baalsmn/kbd-workshop/hachigo74/renders/hachigo74_case_centre.png

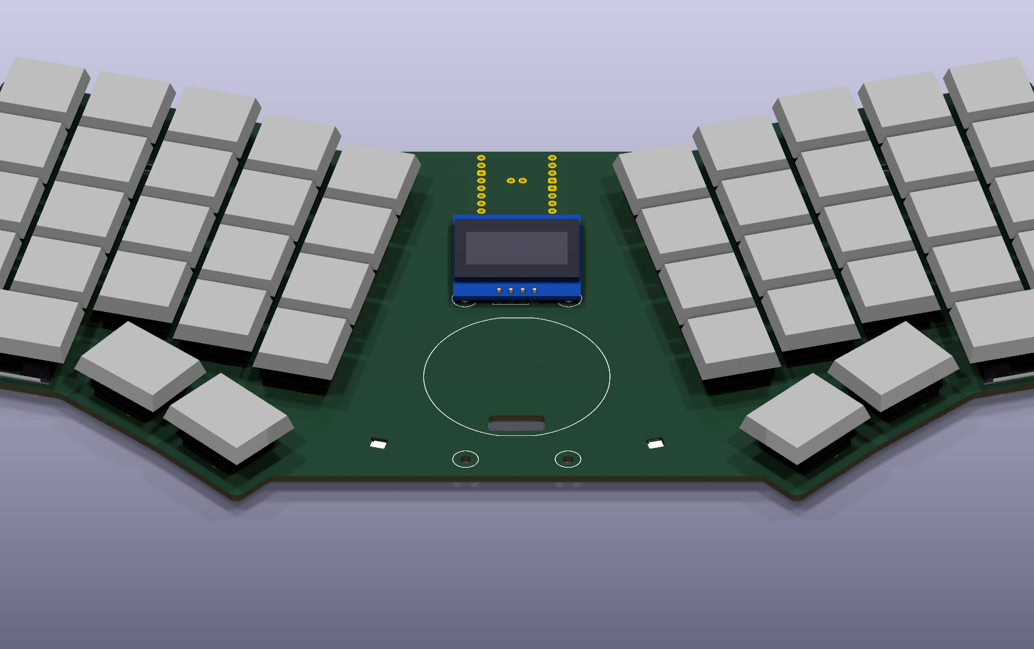
hachigo74/renders/hachigo74_case_centre.png
