baalsmn/kbd-workshop/hachigo74/renders/hachigo74_case_iso.png

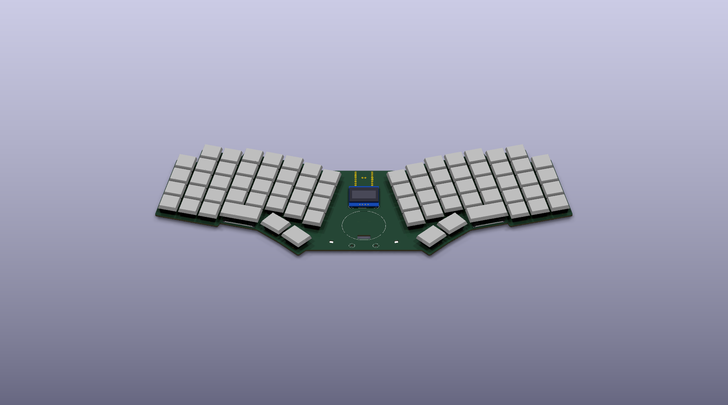
hachigo74/renders/hachigo74_case_iso.png
