baalsmn/kbd-workshop/hachigo74/renders/hachigo74_case_top.png

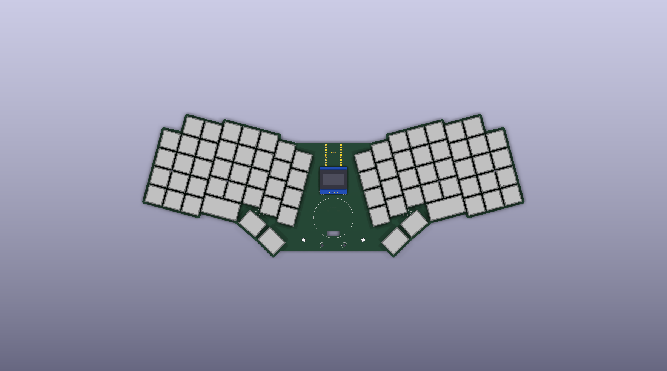
hachigo74/renders/hachigo74_case_top.png
