baalsmn/kbd-workshop/kugo82/kugo82_back.png

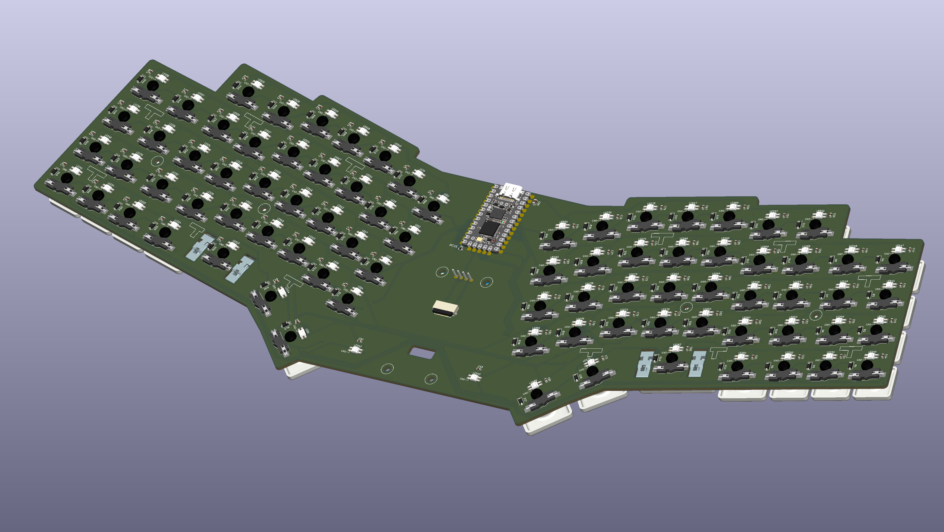
kugo82/kugo82_back.png
