baalsmn/kbd-workshop/kugo82/kugo82_front.png

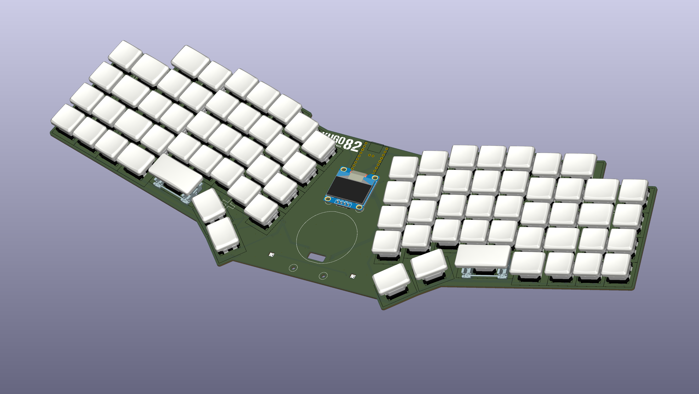
kugo82/kugo82_front.png
