baalsmn/kbd-workshop/hachigo74/case/step/wedge_6deg_assembly.step

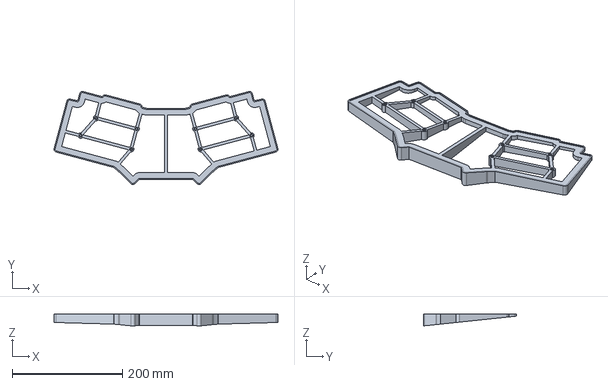
[picture p8: CAD file, 2026-11-07]
hachigo74/case/step/wedge_6deg_assembly.step
406.5 x 168.9 x 21.5 mm
