baalsmn/kbd-workshop/hachigo74/case/fusion/center_cover_threaded.stl

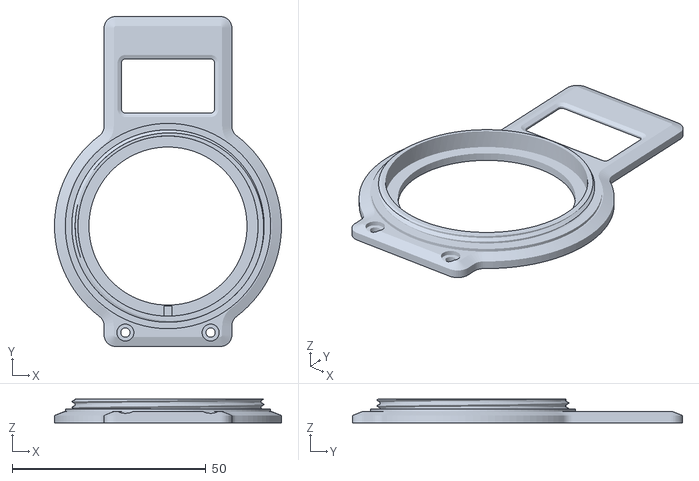
[picture p9: CAD file, 2026-11-07]
hachigo74/case/fusion/center_cover_threaded.stl
58.6 x 85.2 x 6.10
