baalsmn/kbd-workshop/hachigo74/case/step/oled_spacers.step

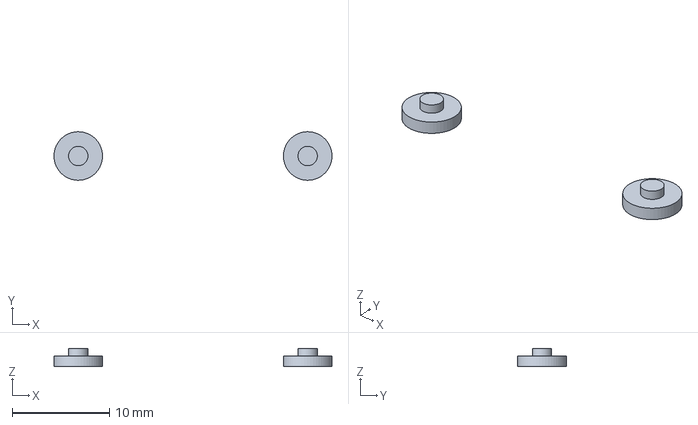
[picture p10: CAD file, 2026-11-07]
hachigo74/case/step/oled_spacers.step
28.6 x 5.00 x 1.90 mm
