baalsmn/kbd-workshop/hachigo74/case/test/switch_cutout_14.06_strip.step

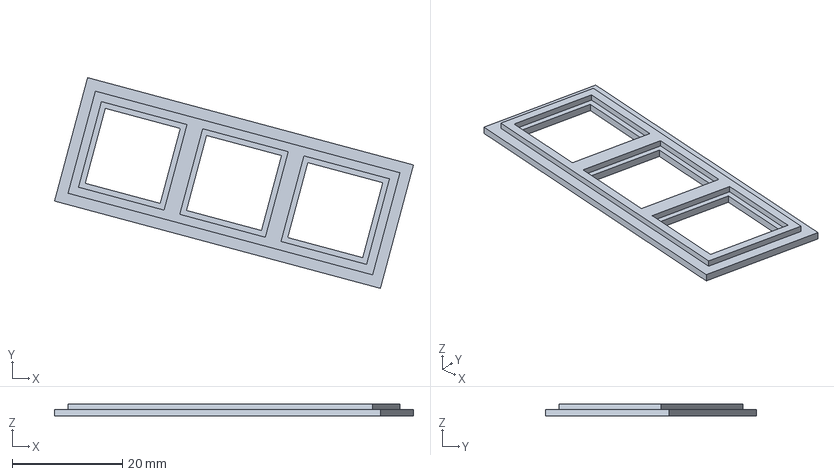
[picture p11: CAD file, 2026-11-04]
hachigo74/case/test/switch_cutout_14.06_strip.step
65.1 x 38.2 x 2.20 mm
