baalsmn/kbd-workshop/keycaps/build/keycap-10-13.step

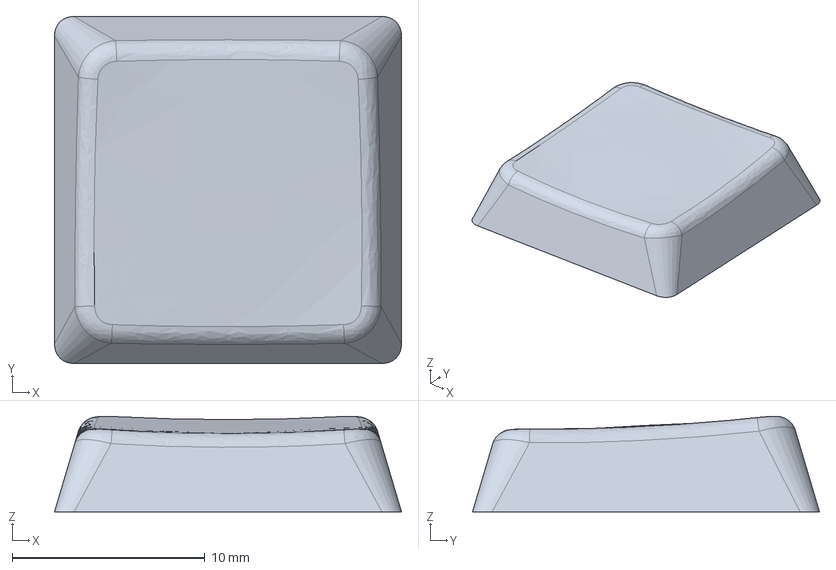
[picture p12: CAD file, 2026-10-24]
keycaps/build/keycap-10-13.step
18.0 x 18.0 x 4.95 mm
