baalsmn/kbd-workshop/keycaps/results/blank/cap_1u_blank.3mf

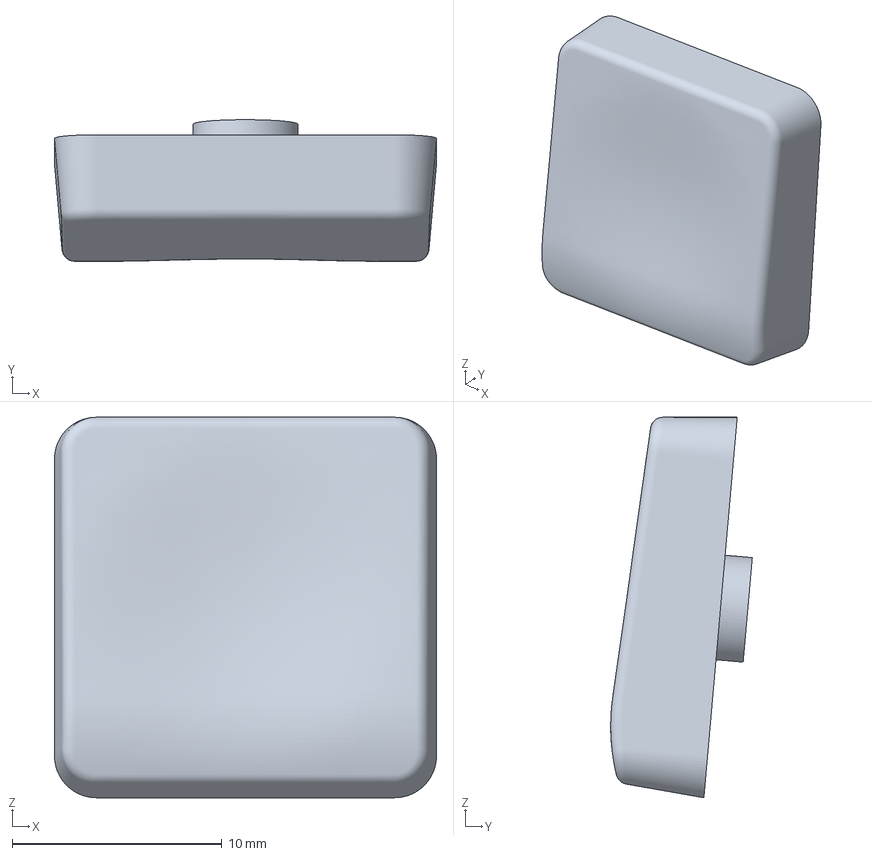
[picture p13: CAD file, 2026-11-10]
keycaps/results/blank/cap_1u_blank.3mf
18.2 x 6.75 x 18.1 mm
