baalsmn/kbd-workshop/keycaps/results/multicolor-legend/cap_1u_A.3mf

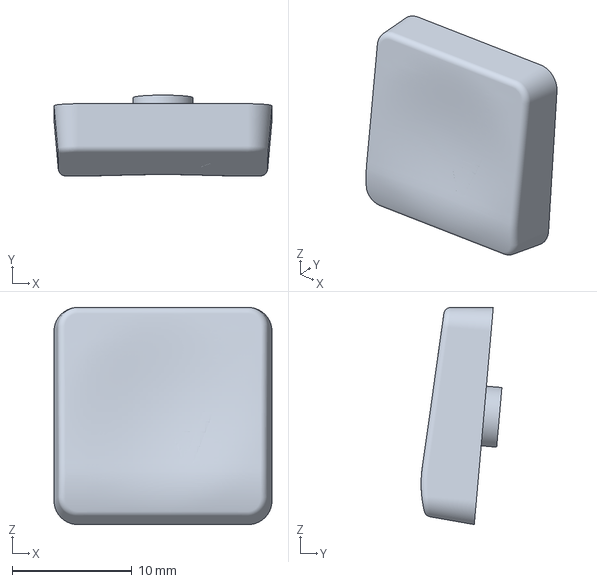
[picture p14: CAD file, 2026-11-10]
keycaps/results/multicolor-legend/cap_1u_A.3mf
18.2 x 6.75 x 18.1 mm
