baalsmn/kbd-workshop/kugo82/case/fusion/trackpad_ring_threaded.stl

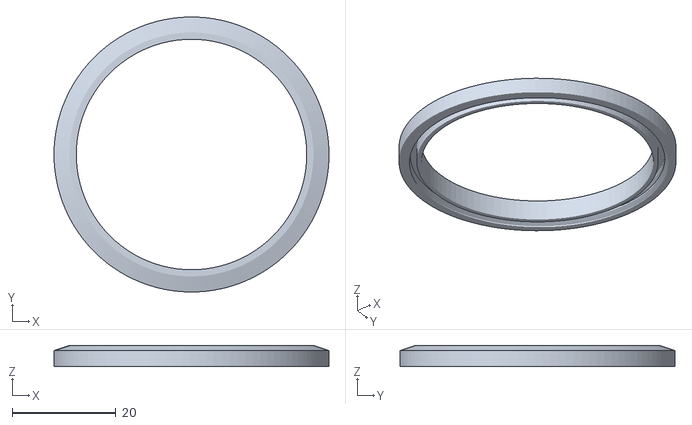
[picture p16: CAD file, 2026-11-07]
kugo82/case/fusion/trackpad_ring_threaded.stl
53.0 x 53.0 x 4.10
