baalsmn/kbd-workshop/kugo82/case/step/tub_left.step

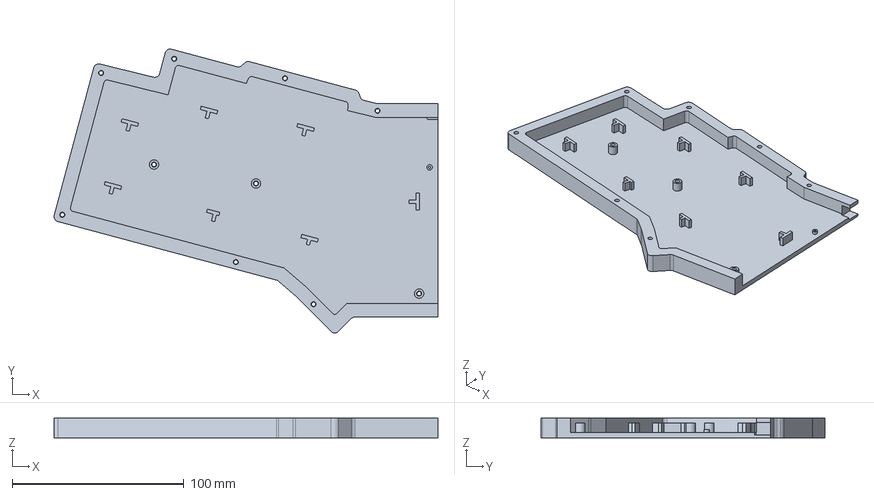
[picture p17: CAD file, 2026-11-07]
kugo82/case/step/tub_left.step
223.9 x 165.5 x 11.4 mm
