baalsmn/kbd-workshop/hachigo74/case/test/dovetail_strip_right.step

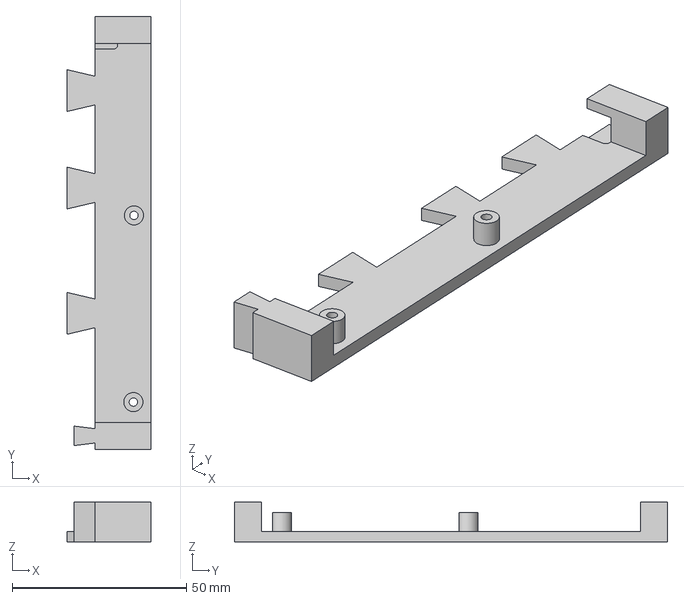
[picture p18: CAD file, 2026-11-04]
hachigo74/case/test/dovetail_strip_right.step
24.0 x 124.4 x 11.4 mm
