baalsmn/kbd-workshop/keycaps/results/blank/cap_1u_slope_0.3mf

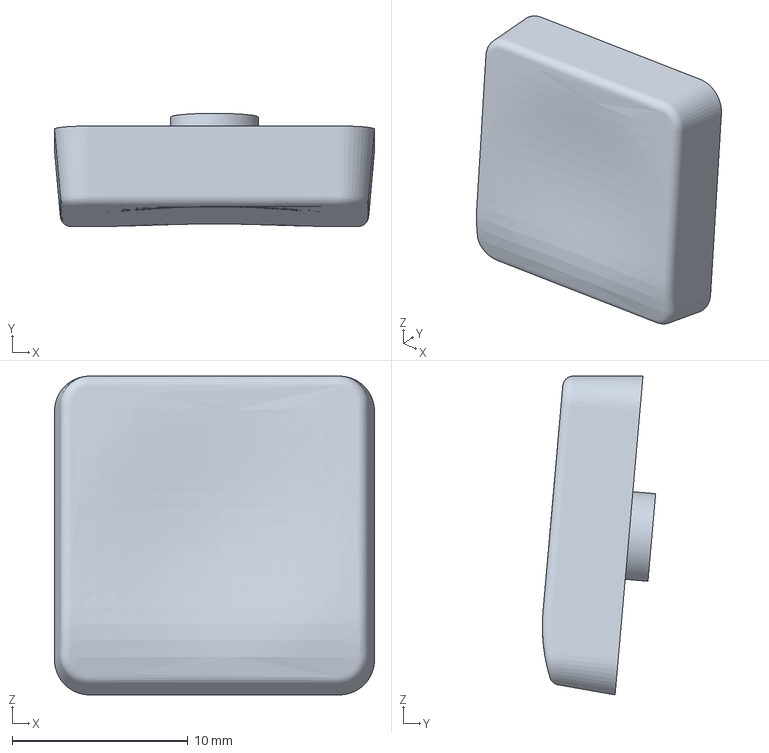
[picture p19: CAD file, 2026-11-10]
keycaps/results/blank/cap_1u_slope_0.3mf
18.2 x 6.44 x 18.1 mm
