baalsmn/kbd-workshop/keycaps/results/multicolor-legend/cap_1.5u_stem+0.5_A.3mf

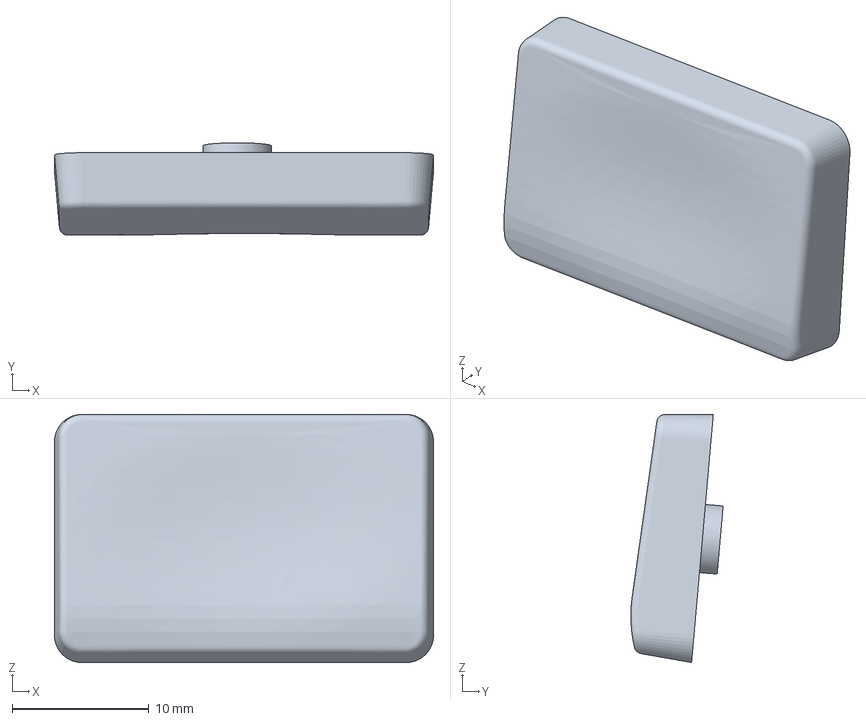
[picture p20: CAD file, 2026-11-10]
keycaps/results/multicolor-legend/cap_1.5u_stem+0.5_A.3mf
27.7 x 6.75 x 18.1 mm
