baalsmn/kbd-workshop/kicad-libraries/3dmodels/vendor_Gateron_KS-57B210T_stabilizer.step

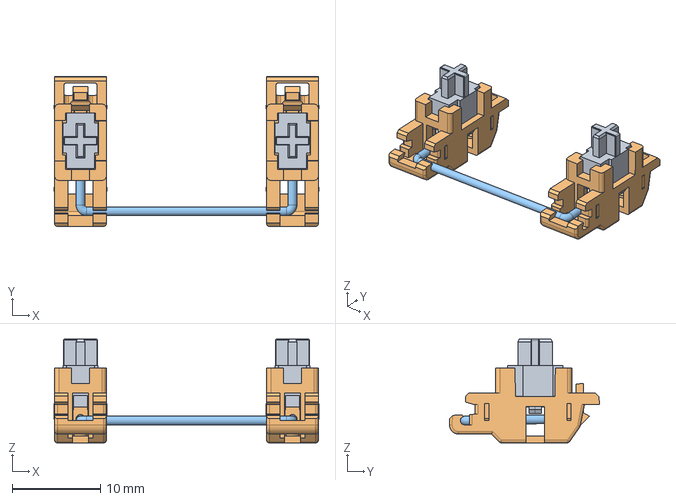
[picture p21: CAD file, 2026-10-22]
kicad-libraries/3dmodels/vendor_Gateron_KS-57B210T_stabilizer.step
30.0 x 17.0 x 11.8 mm
