baalsmn/kbd-workshop/kugo82/case/fusion/cover_clip_chamfered.stl

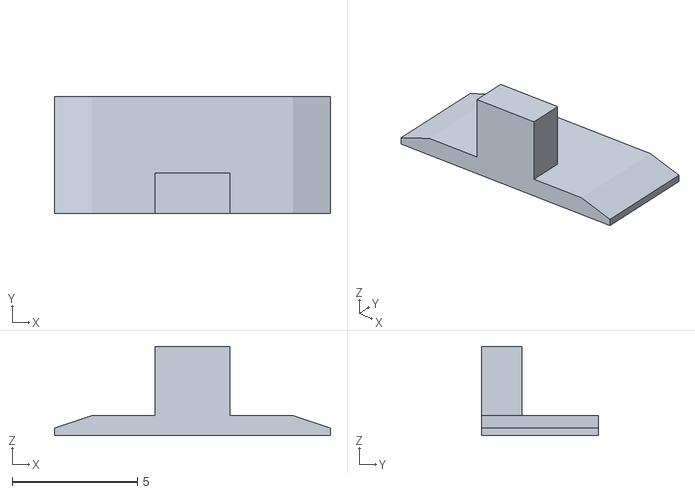
[picture p22: CAD file, 2026-11-07]
kugo82/case/fusion/cover_clip_chamfered.stl
11.0 x 4.65 x 3.55
