baalsmn/kbd-workshop/kugo82/case/step/trackpad_ring.step

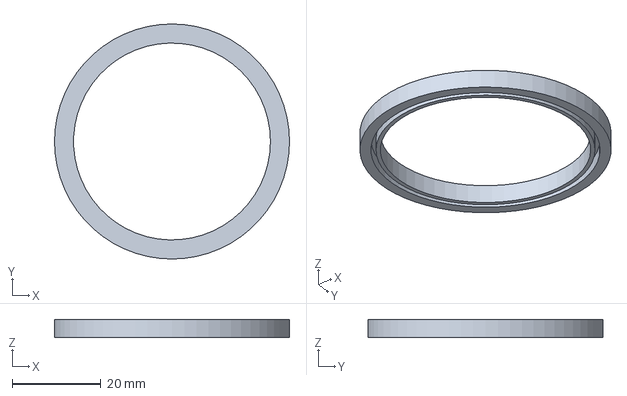
[picture p23: CAD file, 2026-11-07]
kugo82/case/step/trackpad_ring.step
53.0 x 53.0 x 4.10 mm
