baalsmn/kbd-workshop/hachigo74/case/fusion/cover_clip_chamfered.stl

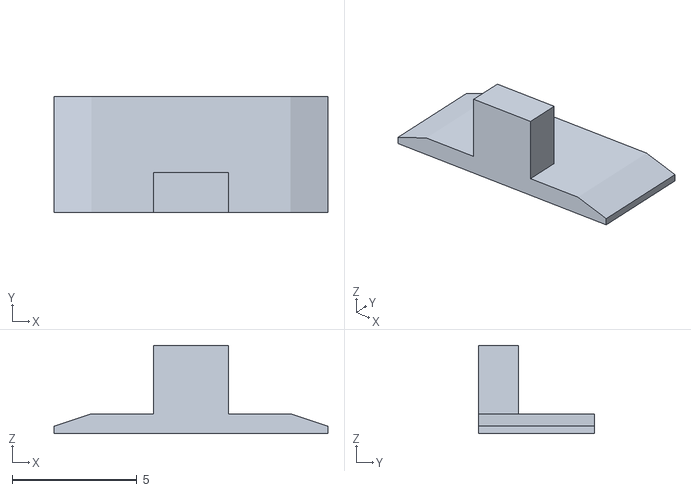
[picture p24: CAD file, 2026-11-07]
hachigo74/case/fusion/cover_clip_chamfered.stl
11.0 x 4.65 x 3.55
