baalsmn/kbd-workshop/hachigo74/case/step/center_bridge.step

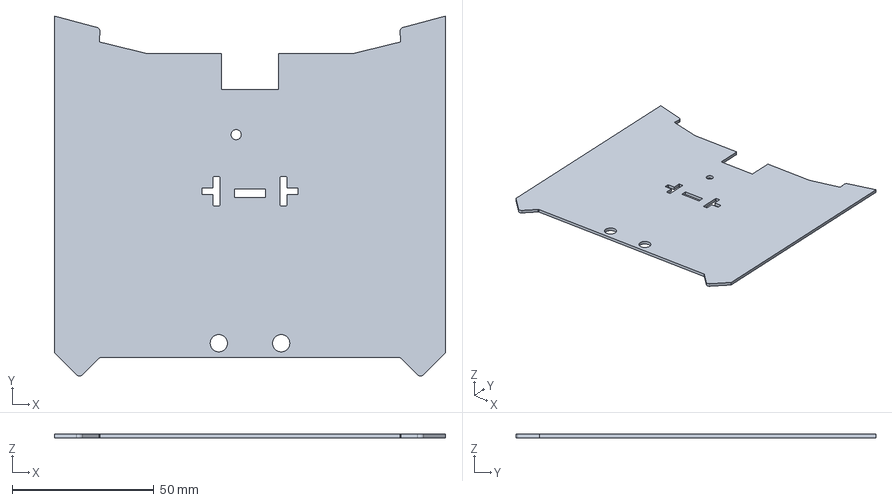
[picture p25: CAD file, 2026-11-07]
hachigo74/case/step/center_bridge.step
138.0 x 127.0 x 1.50 mm
