baalsmn/kbd-workshop/hachigo74/case/test/dovetail_strip_left.step

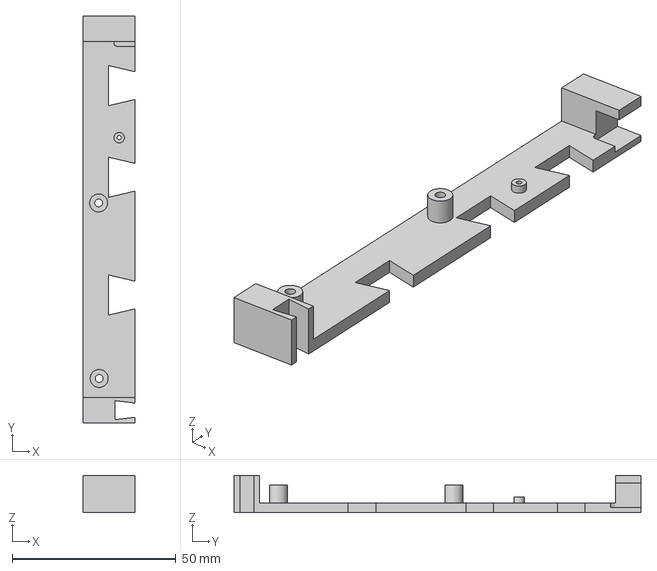
[picture p26: CAD file, 2026-11-04]
hachigo74/case/test/dovetail_strip_left.step
16.0 x 124.4 x 11.4 mm
