baalsmn/kbd-workshop/keycaps/results/multicolor-legend/cap_2u_stab_A.3mf

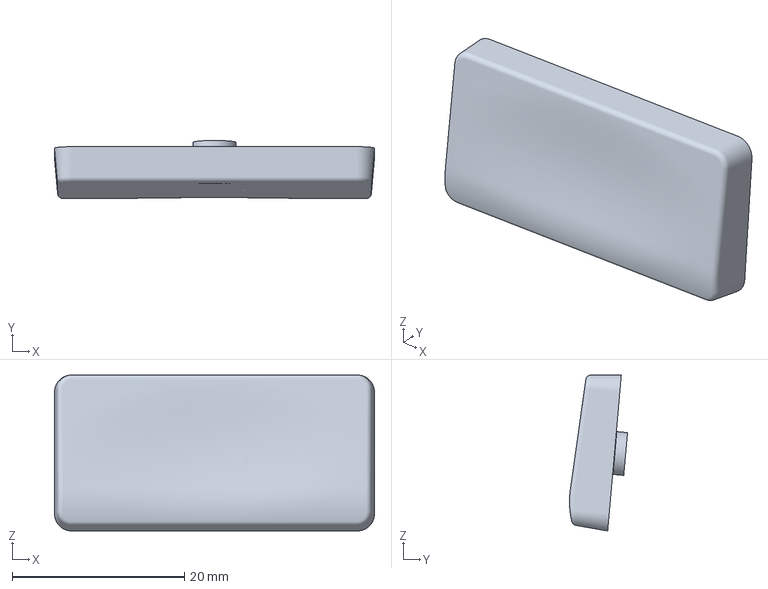
[picture p28: CAD file, 2026-11-10]
keycaps/results/multicolor-legend/cap_2u_stab_A.3mf
37.2 x 6.75 x 18.1 mm
