baalsmn/kbd-workshop/kicad-libraries/3dmodels/vendor_Gateron_KS-2P02B01-02_socket.step

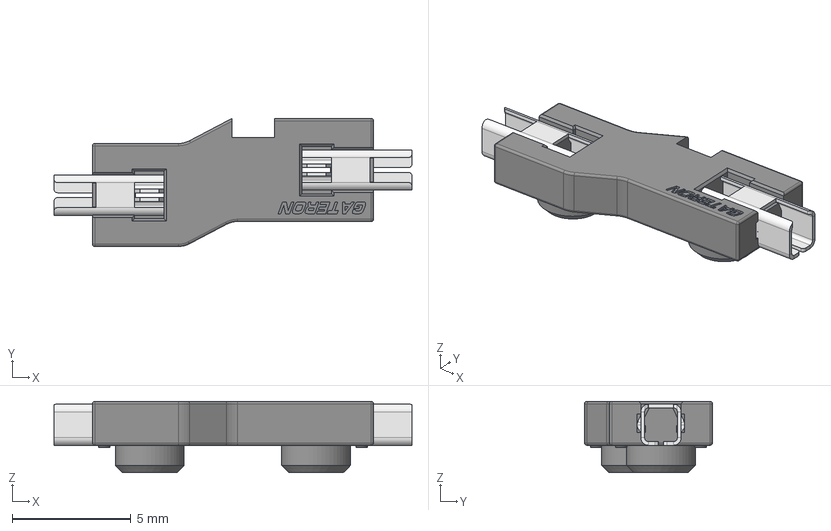
[picture p29: CAD file, 2026-10-22]
kicad-libraries/3dmodels/vendor_Gateron_KS-2P02B01-02_socket.step
15.1 x 5.39 x 3.00 mm
