baalsmn/kbd-workshop/hachigo74/case/step/tub_right.step

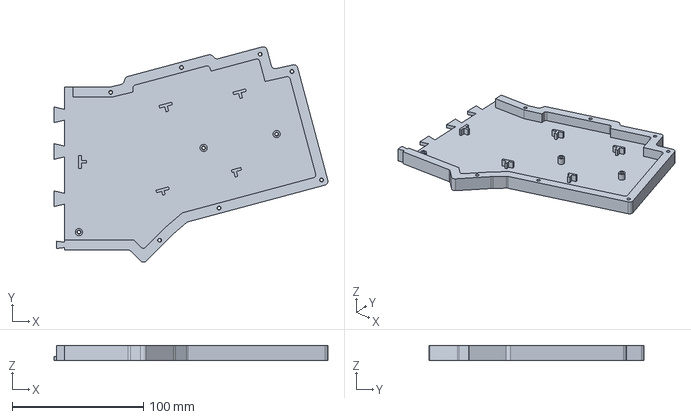
[picture p30: CAD file, 2026-11-07]
hachigo74/case/step/tub_right.step
208.9 x 164.3 x 11.4 mm
