baalsmn/kbd-workshop/keycaps/results/blank/cap_1.5u_stem+0.5_blank.3mf

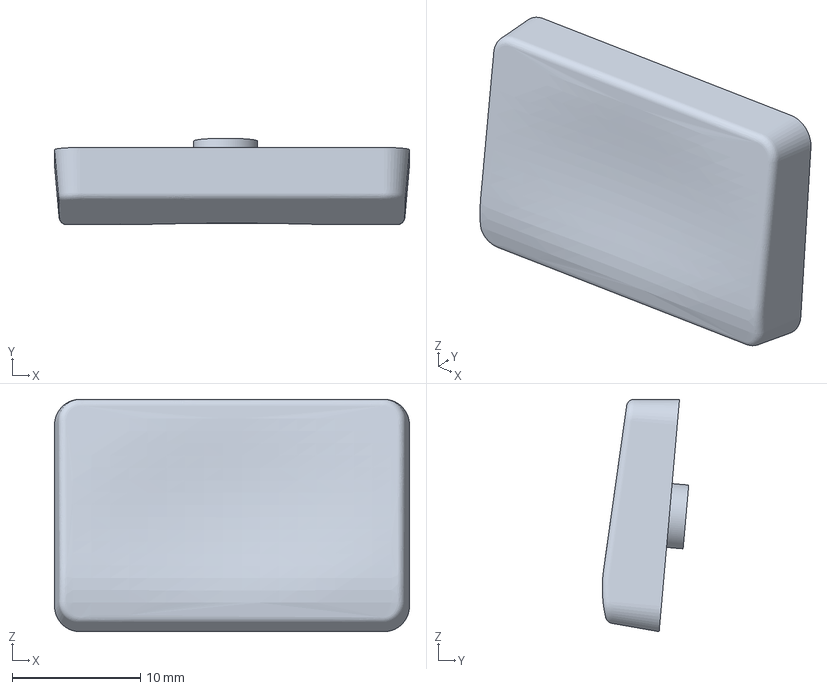
[picture p31: CAD file, 2026-11-10]
keycaps/results/blank/cap_1.5u_stem+0.5_blank.3mf
27.7 x 6.75 x 18.1 mm
