baalsmn/kbd-workshop/keycaps/results/multicolor-legend/cap_1.25u_thumb_stem+1.5_A.3mf

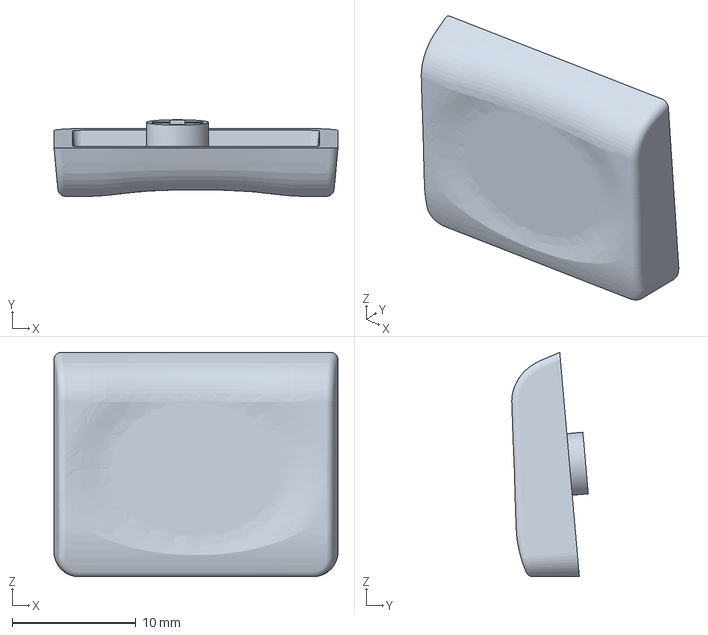
[picture p32: CAD file, 2026-11-10]
keycaps/results/multicolor-legend/cap_1.25u_thumb_stem+1.5_A.3mf
22.9 x 6.19 x 18.1 mm
