baalsmn/kbd-workshop/kicad-libraries/3dmodels/vendor_SK6812MINI-E.step

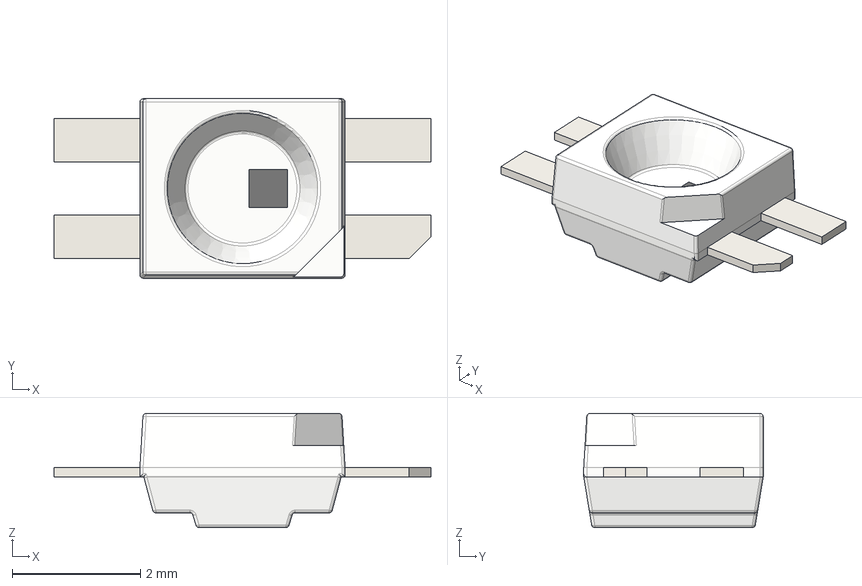
[picture p33: CAD file, 2026-10-22]
kicad-libraries/3dmodels/vendor_SK6812MINI-E.step
5.88 x 2.80 x 1.78 mm
