baalsmn/kbd-workshop/hachigo74/case/step/wedge_6deg_right.step

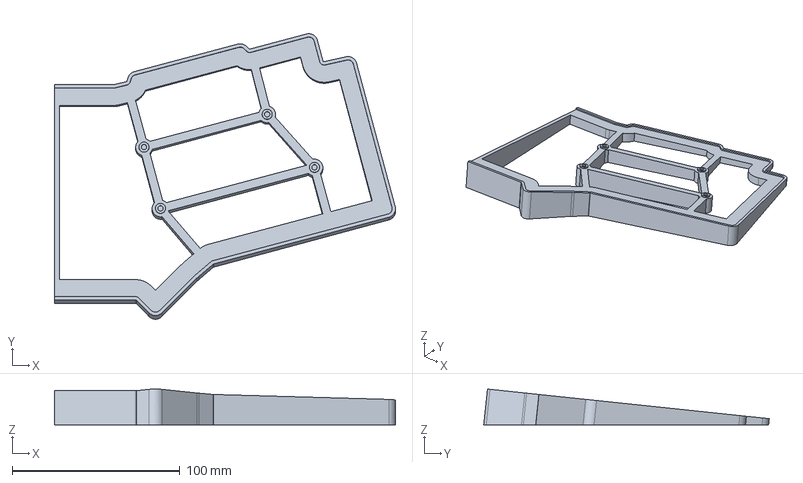
[picture p34: CAD file, 2026-11-07]
hachigo74/case/step/wedge_6deg_right.step
203.2 x 170.2 x 21.4 mm
