baalsmn/kbd-workshop/keycaps/results/multicolor-legend/cap_1.25u_A.3mf

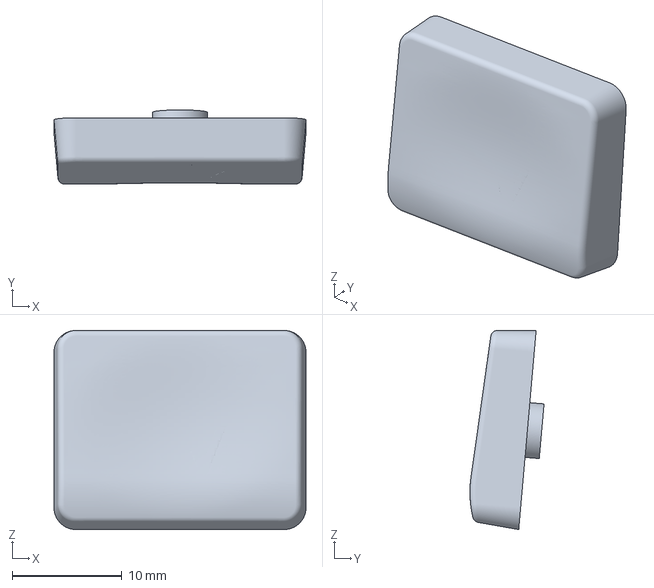
[picture p36: CAD file, 2026-11-10]
keycaps/results/multicolor-legend/cap_1.25u_A.3mf
22.9 x 6.75 x 18.1 mm
