baalsmn/kbd-workshop/kicad-libraries/3dmodels/vendor_OLED_128x64.step

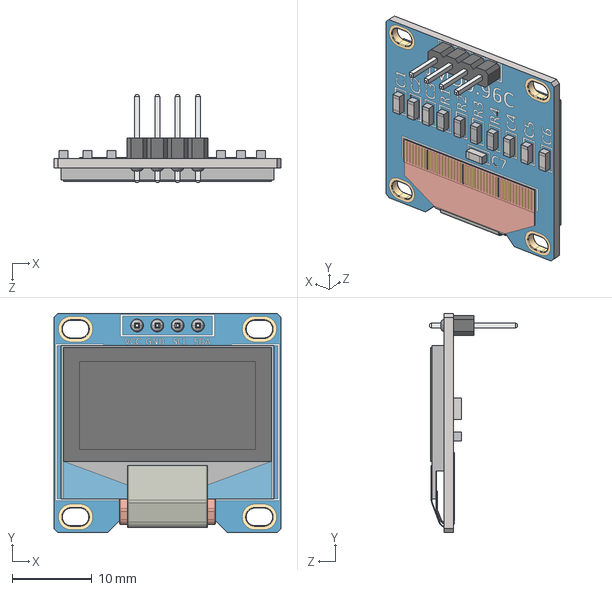
[picture p37: CAD file, 2026-10-22]
kicad-libraries/3dmodels/vendor_OLED_128x64.step
28.4 x 27.4 x 11.0 mm
