baalsmn/kbd-workshop/hachigo74/case/step/tub_left.step

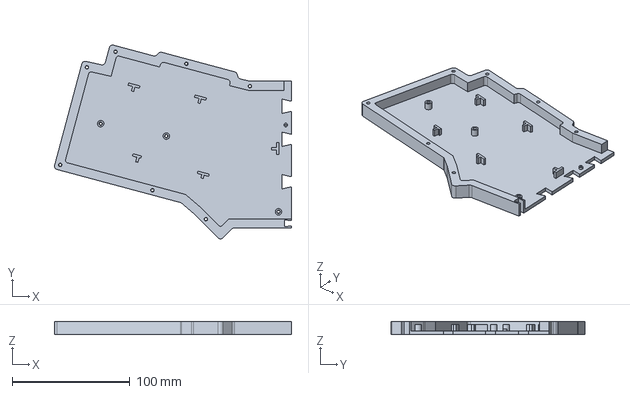
[picture p38: CAD file, 2026-11-07]
hachigo74/case/step/tub_left.step
200.9 x 164.3 x 11.4 mm
