baalsmn/kbd-workshop/keycaps/results/blank/cap_2u_stab_level_blank.3mf

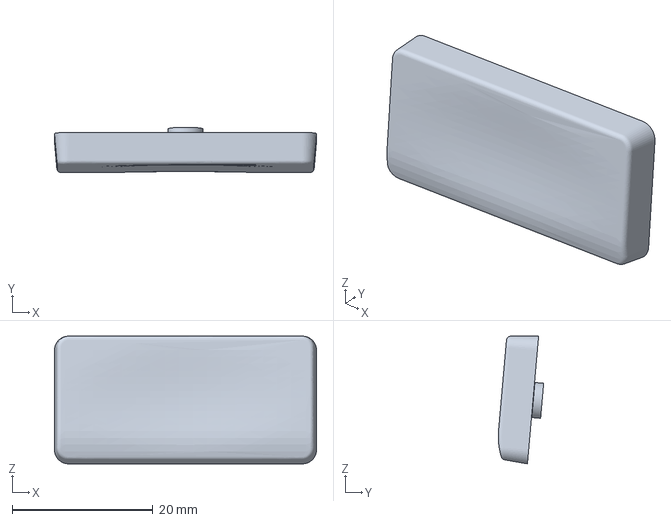
[picture p39: CAD file, 2026-11-10]
keycaps/results/blank/cap_2u_stab_level_blank.3mf
37.2 x 6.44 x 18.1 mm
