baalsmn/kbd-workshop/keycaps/results/multicolor-legend/cap_1u_tall_A.3mf

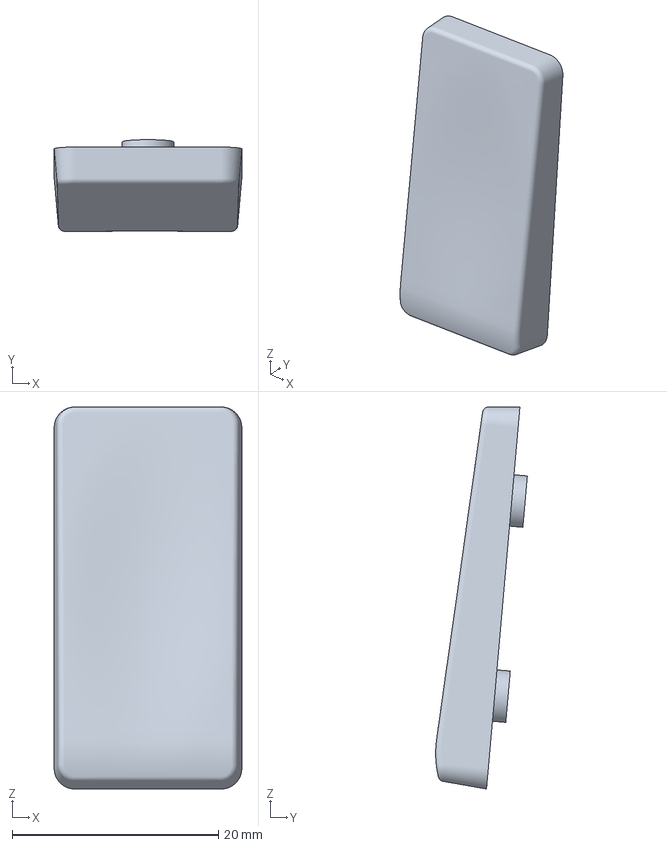
[picture p40: CAD file, 2026-11-10]
keycaps/results/multicolor-legend/cap_1u_tall_A.3mf
18.2 x 8.90 x 37.1 mm
