baalsmn/kbd-workshop/kugo82/case/step/lid_right.step

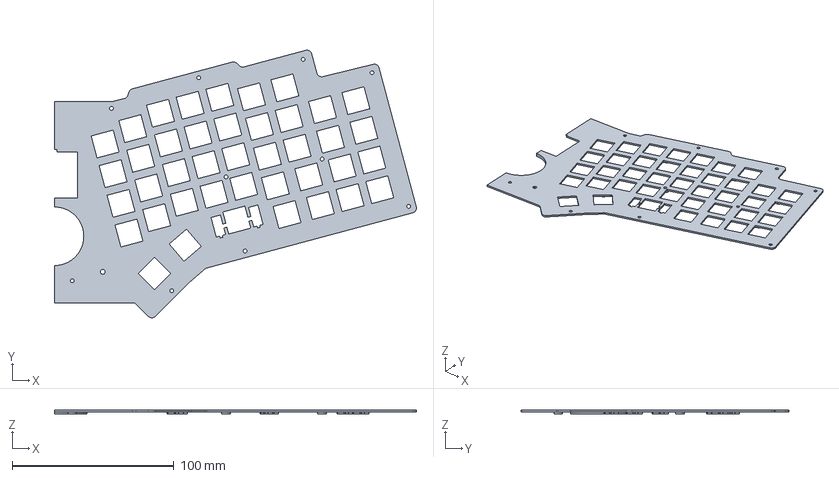
[picture p41: CAD file, 2026-11-07]
kugo82/case/step/lid_right.step
223.9 x 165.5 x 2.50 mm
