baalsmn/kbd-workshop/keycaps/results/blank/cap_1u_tall_blank.3mf

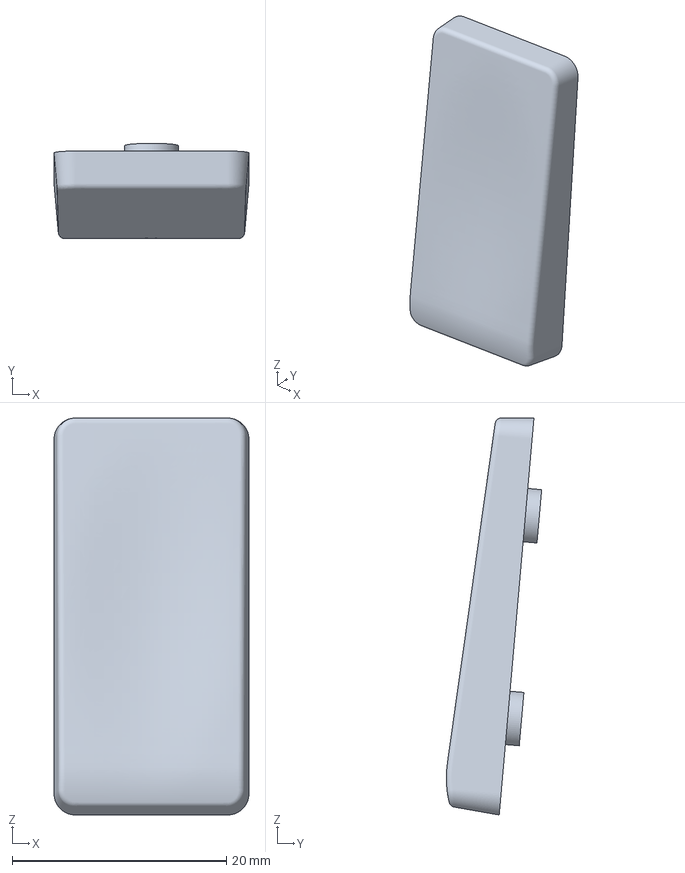
[picture p42: CAD file, 2026-11-10]
keycaps/results/blank/cap_1u_tall_blank.3mf
18.2 x 8.90 x 37.1 mm
