baalsmn/kbd-workshop/hachigo74/case/step/lid_left.step

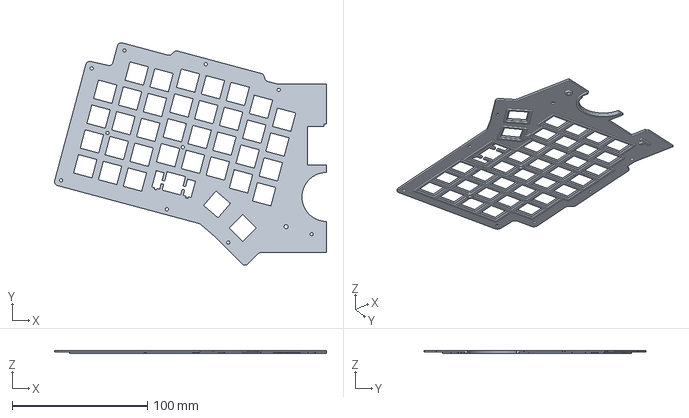
[picture p43: CAD file, 2026-11-07]
hachigo74/case/step/lid_left.step
200.9 x 164.3 x 2.50 mm
