baalsmn/kbd-workshop/keycaps/results/blank/cap_1.25u_level_blank.3mf

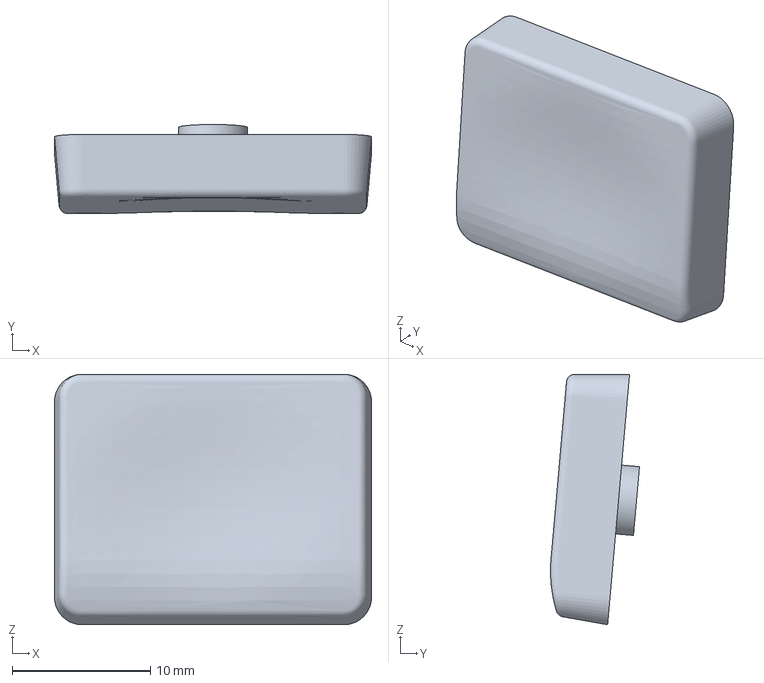
[picture p44: CAD file, 2026-11-10]
keycaps/results/blank/cap_1.25u_level_blank.3mf
22.9 x 6.44 x 18.1 mm
