baalsmn/kbd-workshop/keycaps/results/blank/cap_2u_stab_blank.3mf

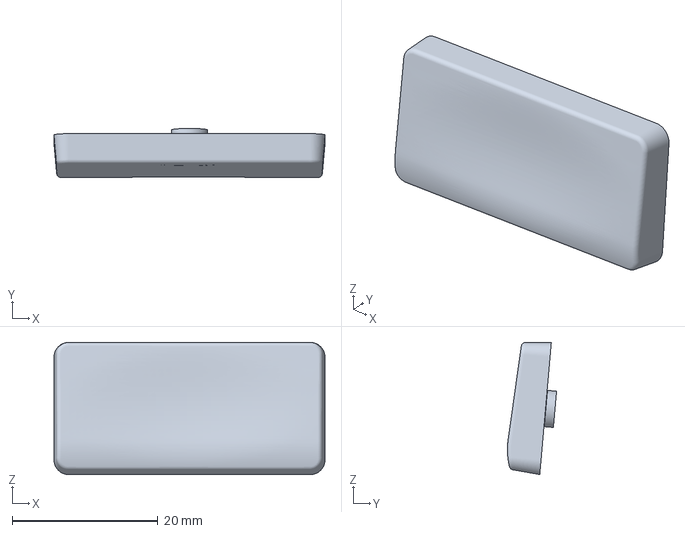
[picture p45: CAD file, 2026-11-10]
keycaps/results/blank/cap_2u_stab_blank.3mf
37.2 x 6.75 x 18.1 mm
