baalsmn/kbd-workshop/keycaps/results/multicolor-legend/cap_1.35u_level_A.3mf

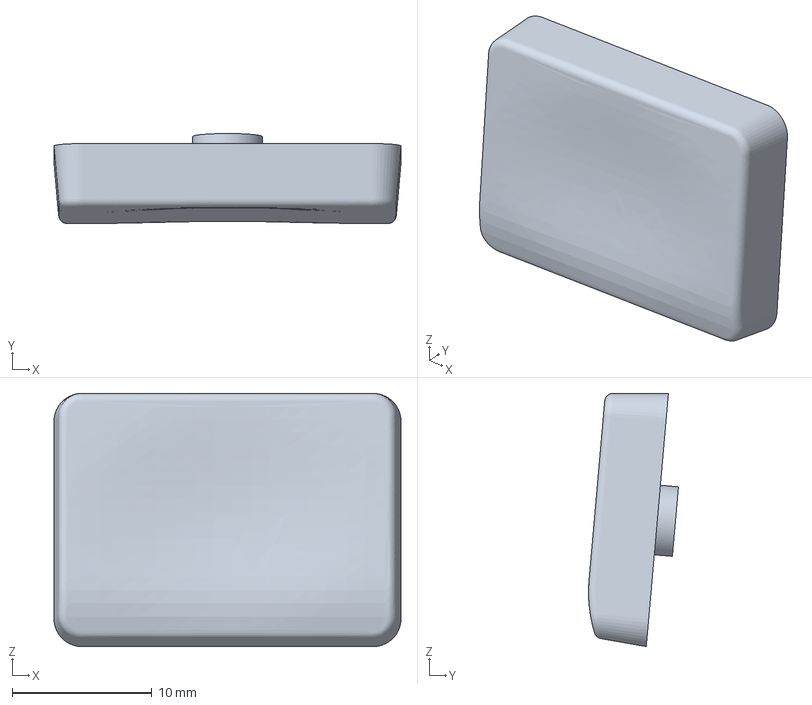
[picture p46: CAD file, 2026-11-10]
keycaps/results/multicolor-legend/cap_1.35u_level_A.3mf
24.9 x 6.44 x 18.1 mm
