baalsmn/kbd-workshop/keycaps/results/multicolor-legend/cap_2u_stab_level_A.3mf

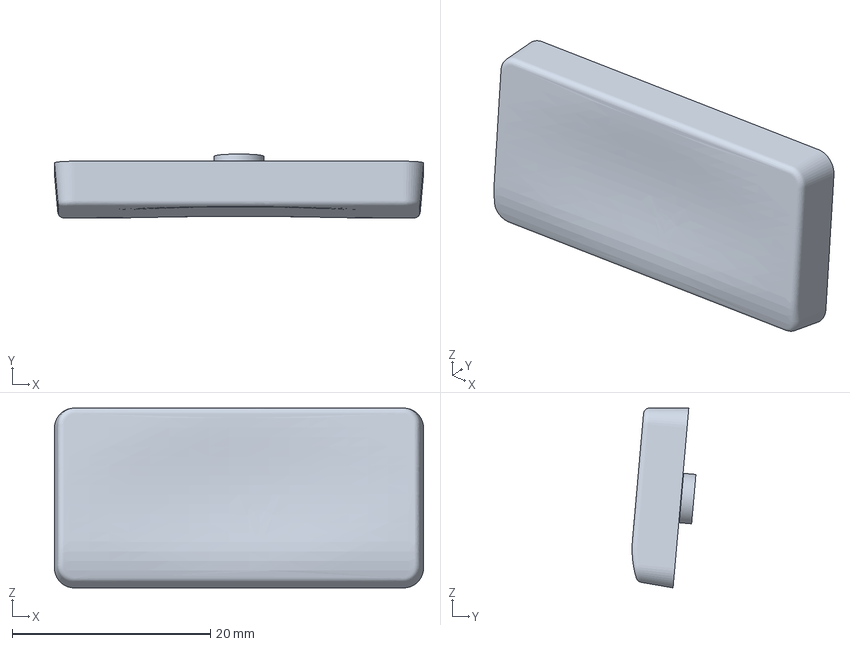
[picture p48: CAD file, 2026-11-10]
keycaps/results/multicolor-legend/cap_2u_stab_level_A.3mf
37.2 x 6.44 x 18.1 mm
