baalsmn/kbd-workshop/keycaps/results/multicolor-legend/cap_2u_stab_thumb_A.3mf

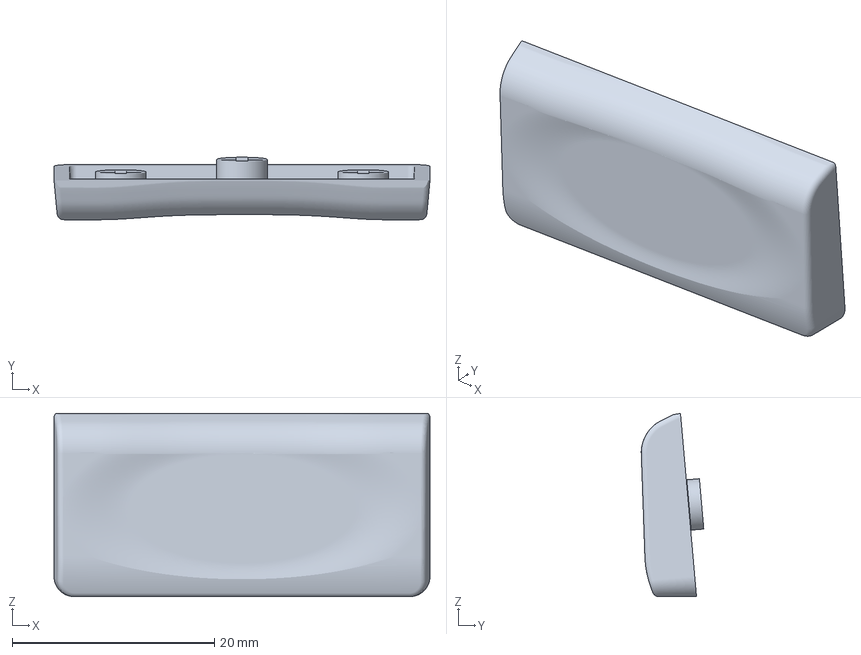
[picture p51: CAD file, 2026-11-10]
keycaps/results/multicolor-legend/cap_2u_stab_thumb_A.3mf
37.2 x 6.19 x 18.1 mm
