baalsmn/kbd-workshop/keycaps/results/blank/cap_1.5u_level_stem+0.5_blank.3mf

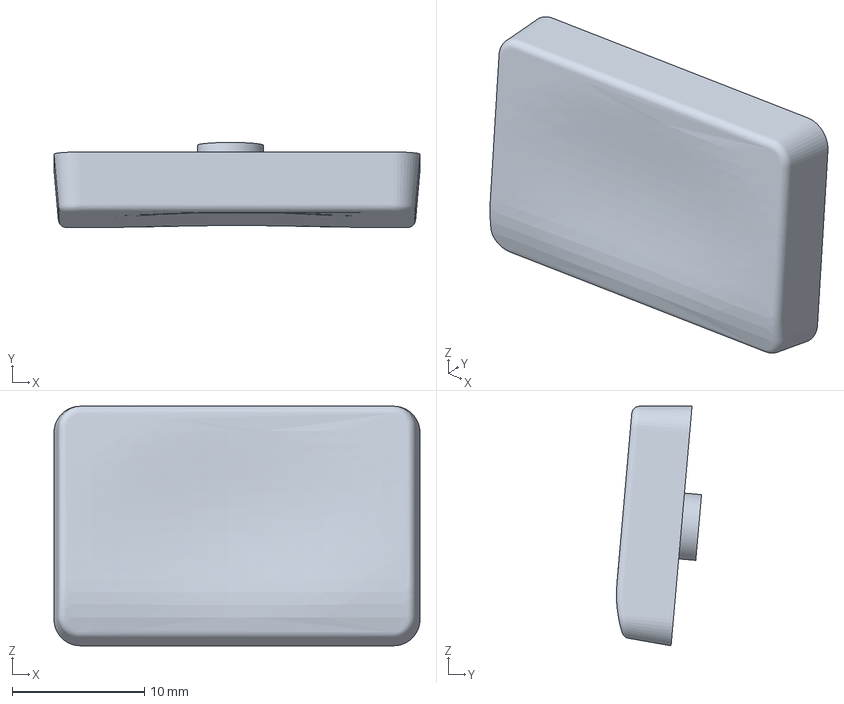
[picture p52: CAD file, 2026-11-10]
keycaps/results/blank/cap_1.5u_level_stem+0.5_blank.3mf
27.7 x 6.44 x 18.1 mm
