baalsmn/kbd-workshop/keycaps/results/multicolor-legend/cap_1.5u_level_stem+0.5_A.3mf

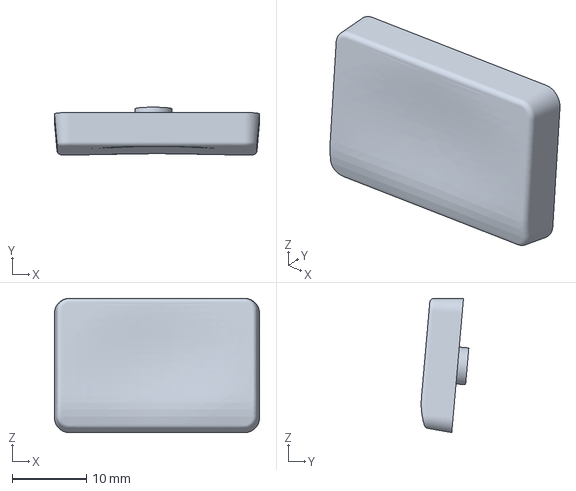
[picture p53: CAD file, 2026-11-10]
keycaps/results/multicolor-legend/cap_1.5u_level_stem+0.5_A.3mf
27.7 x 6.44 x 18.1 mm
