baalsmn/kbd-workshop/keycaps/results/multicolor-legend/cap_1.35u_A.3mf

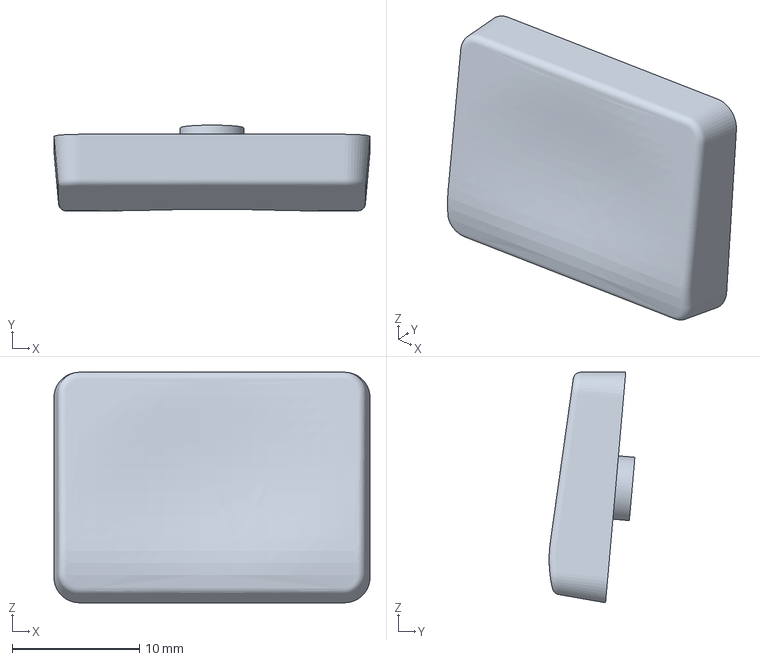
[picture p54: CAD file, 2026-11-10]
keycaps/results/multicolor-legend/cap_1.35u_A.3mf
24.9 x 6.75 x 18.1 mm
