baalsmn/kbd-workshop/keycaps/results/blank/cap_1.25u_thumb_stem+1.5_blank.3mf

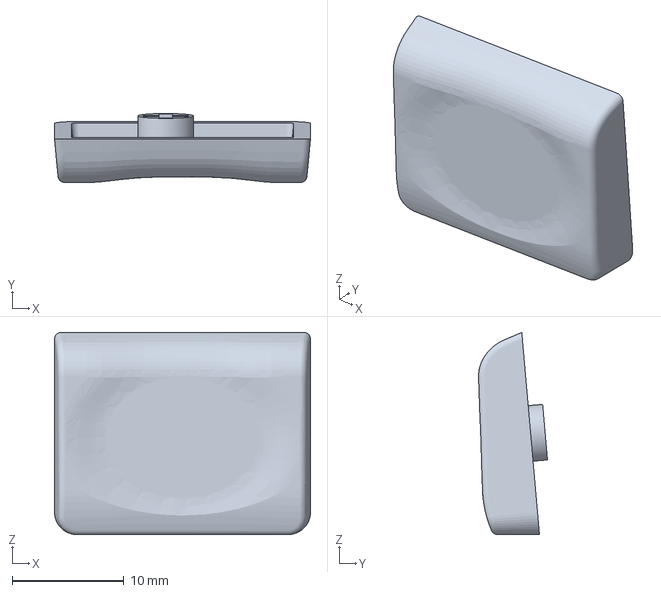
[picture p55: CAD file, 2026-11-10]
keycaps/results/blank/cap_1.25u_thumb_stem+1.5_blank.3mf
22.9 x 6.19 x 18.1 mm
