baalsmn/kbd-workshop/(list of files, cad)

Other CAD files:
hachigo74/case/fusion/trackpad_ring_threaded.stl
kugo82/case/fusion/center_cover_threaded.stl
kugo82/case/step/tub_right.step
kugo82/case/step/cover_clip.step
kugo82/case/step/oled_spacers.step
hachigo74/case/step/center_cover.step
keycaps/results/multicolor-legend/cap_1.25u_thumb_A.3mf
kugo82/case/step/center_cover.step
keycaps/results/multicolor-legend/cap_1.25u_stem+1.5_A.3mf
kugo82/case/step/lid_left.step
hachigo74/case/step/wedge_6deg_left.step
hachigo74/case/step/cover_clip.step
hachigo74/case/step/lid_right.step
keycaps/results/blank/cap_1.25u_stem+1.5_blank.3mf
keycaps/results/multicolor-legend/cap_1.5u_A.3mf
hachigo74/case/step/trackpad_ring.step
keycaps/results/blank/cap_1.25u_level_stem+1.5_blank.3mf
keycaps/results/blank/cap_1u_slope_+3.3mf
keycaps/results/multicolor-legend/cap_1.25u_level_stem+1.5_A.3mf
keycaps/results/blank/cap_1.25u_thumb_blank.3mf
keycaps/results/blank/cap_1.5u_blank.3mf
hachigo74/case/center_bridge.stl
hachigo74/case/center_cover.stl
hachigo74/case/cover_clip.stl
hachigo74/case/fusion/hachigo74_case.f3d
hachigo74/case/fusion/spacers.f3d
hachigo74/case/lid_left.stl
hachigo74/case/lid_right.stl
hachigo74/case/oled_spacers.stl
hachigo74/case/test/dovetail_strip.f3d
hachigo74/case/test/dovetail_strip_left.stl
hachigo74/case/test/dovetail_strip_right.stl
hachigo74/case/test/switch_cutout_14.06_strip.stl
hachigo74/case/trackpad_ring.stl
hachigo74/case/tub_left.stl
hachigo74/case/tub_right.stl
hachigo74/case/wedge_6deg_left.stl
hachigo74/case/wedge_6deg_right.stl
keycaps/results/blank/cap_1.25u_level_stem-1.5_blank.3mf
keycaps/results/blank/cap_1.25u_stem-1.5_blank.3mf
keycaps/results/blank/cap_1.25u_thumb_stem-1.5_blank.3mf
keycaps/results/blank/cap_1.5u_level_stem-0.5_blank.3mf
keycaps/results/blank/cap_1.5u_stem-0.5_blank.3mf
keycaps/results/blank/cap_1u_slope_-3.3mf
keycaps/results/multicolor-legend/cap_1.25u_level_stem-1.5_A.3mf
keycaps/results/multicolor-legend/cap_1.25u_stem-1.5_A.3mf
keycaps/results/multicolor-legend/cap_1.25u_thumb_stem-1.5_A.3mf
keycaps/results/multicolor-legend/cap_1.5u_level_stem-0.5_A.3mf
keycaps/results/multicolor-legend/cap_1.5u_stem-0.5_A.3mf
kugo82/case/center_cover.stl
kugo82/case/cover_clip.stl
kugo82/case/fusion/kugo82_case.f3d
kugo82/case/lid_left.stl
kugo82/case/lid_right.stl
kugo82/case/oled_spacers.stl
kugo82/case/trackpad_ring.stl
kugo82/case/tub_left.stl
kugo82/case/tub_right.stl
