baalsmn/kbd-workshop/hachigo74/hachigo74_layout_1to1.pdf

# hachigo74 left half 1:1 scale

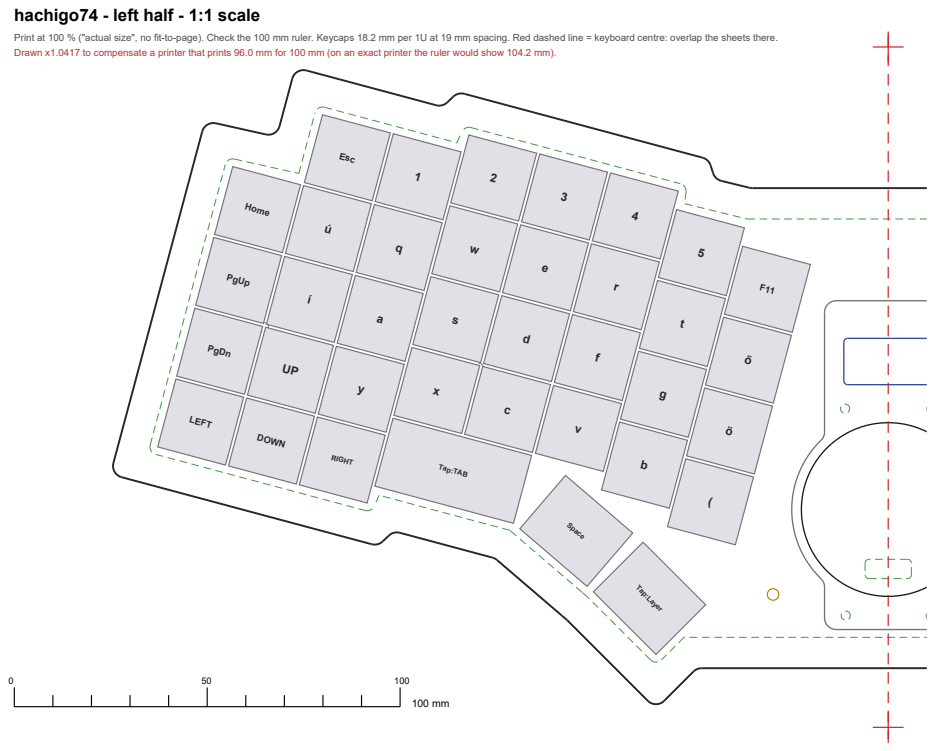
[picture p56: page 1]
LEFT; PgDn; PgUp; Home; DOWN; Esc; RIGHT; Tap:TAB; Space; Tap:Layer

Print at 100 % ("actual size", no fittopage). Check the 100 mm ruler. Keycaps 18.2 mm per 1U at 19 mm spacing. Red dashed line = keyboard centre: overlap the sheets there.
Drawn x1.0417 to compensate a printer that prints 96.0 mm for 100 mm (on an exact printer the ruler would show 104.2 mm).

# hachigo74 right half 1:1 scale

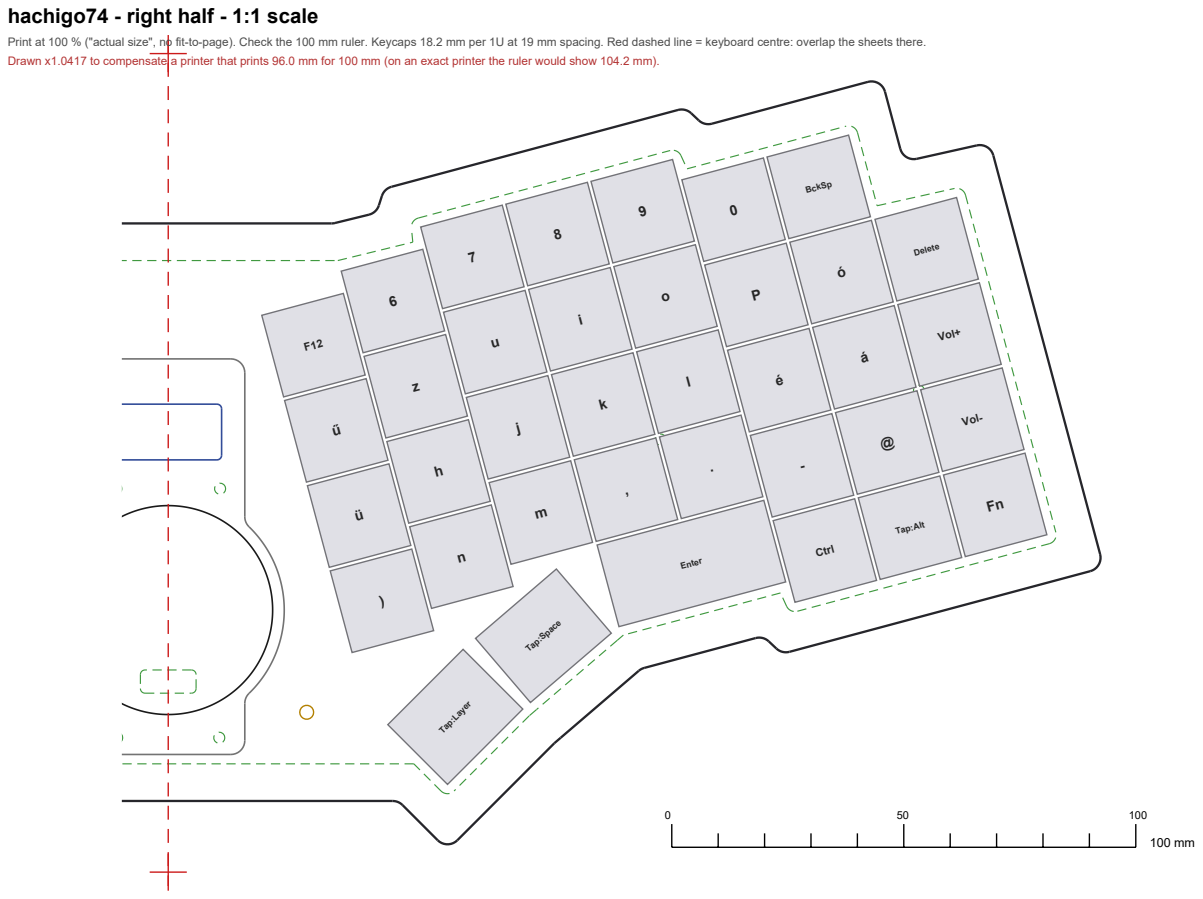
[picture p57: page 2]
Vol-; Vol+; Delete; Tap:Alt; BckSp; Ctrl; Enter; Tap:Space; Tap:Layer

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
