baalsmn/kbd-workshop/hachigo74/kicad/hachigo74.kicad_pcb

## KiCad design hachigo74/kicad/hachigo74.kicad_pcb (2026-11-10)

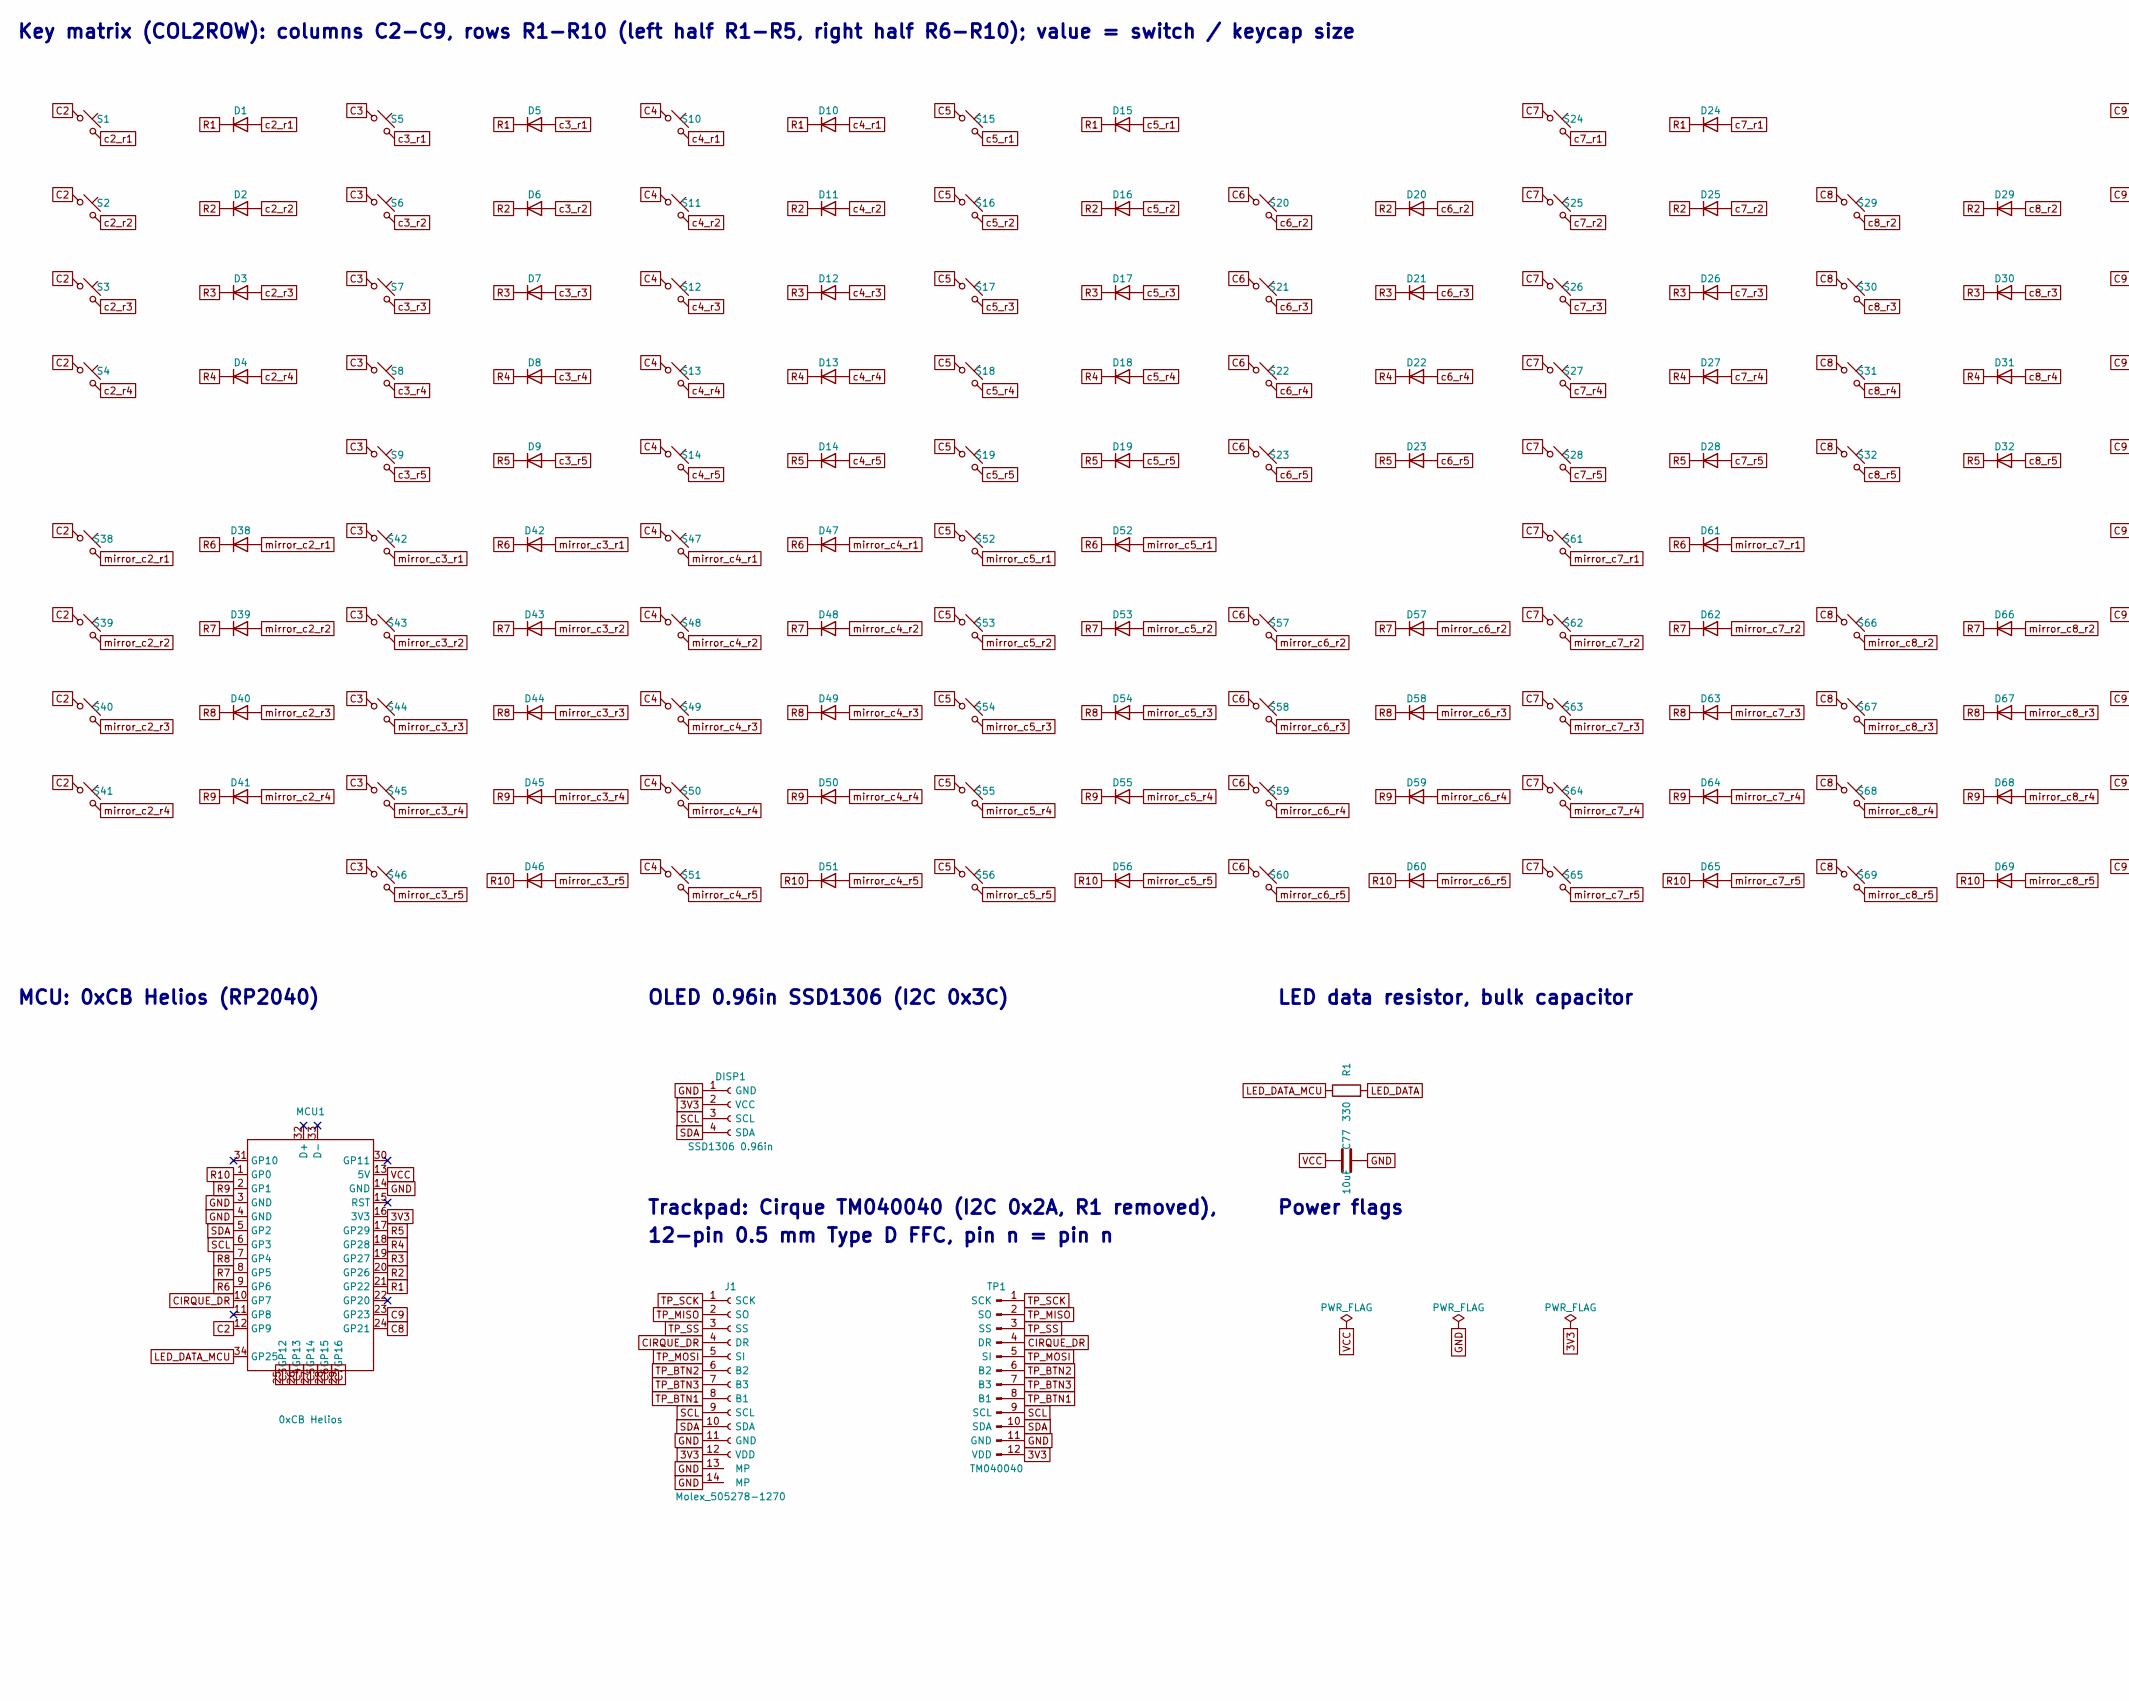
[picture p58: schematic hachigo74.kicad_sch, part in row 1, column 1]

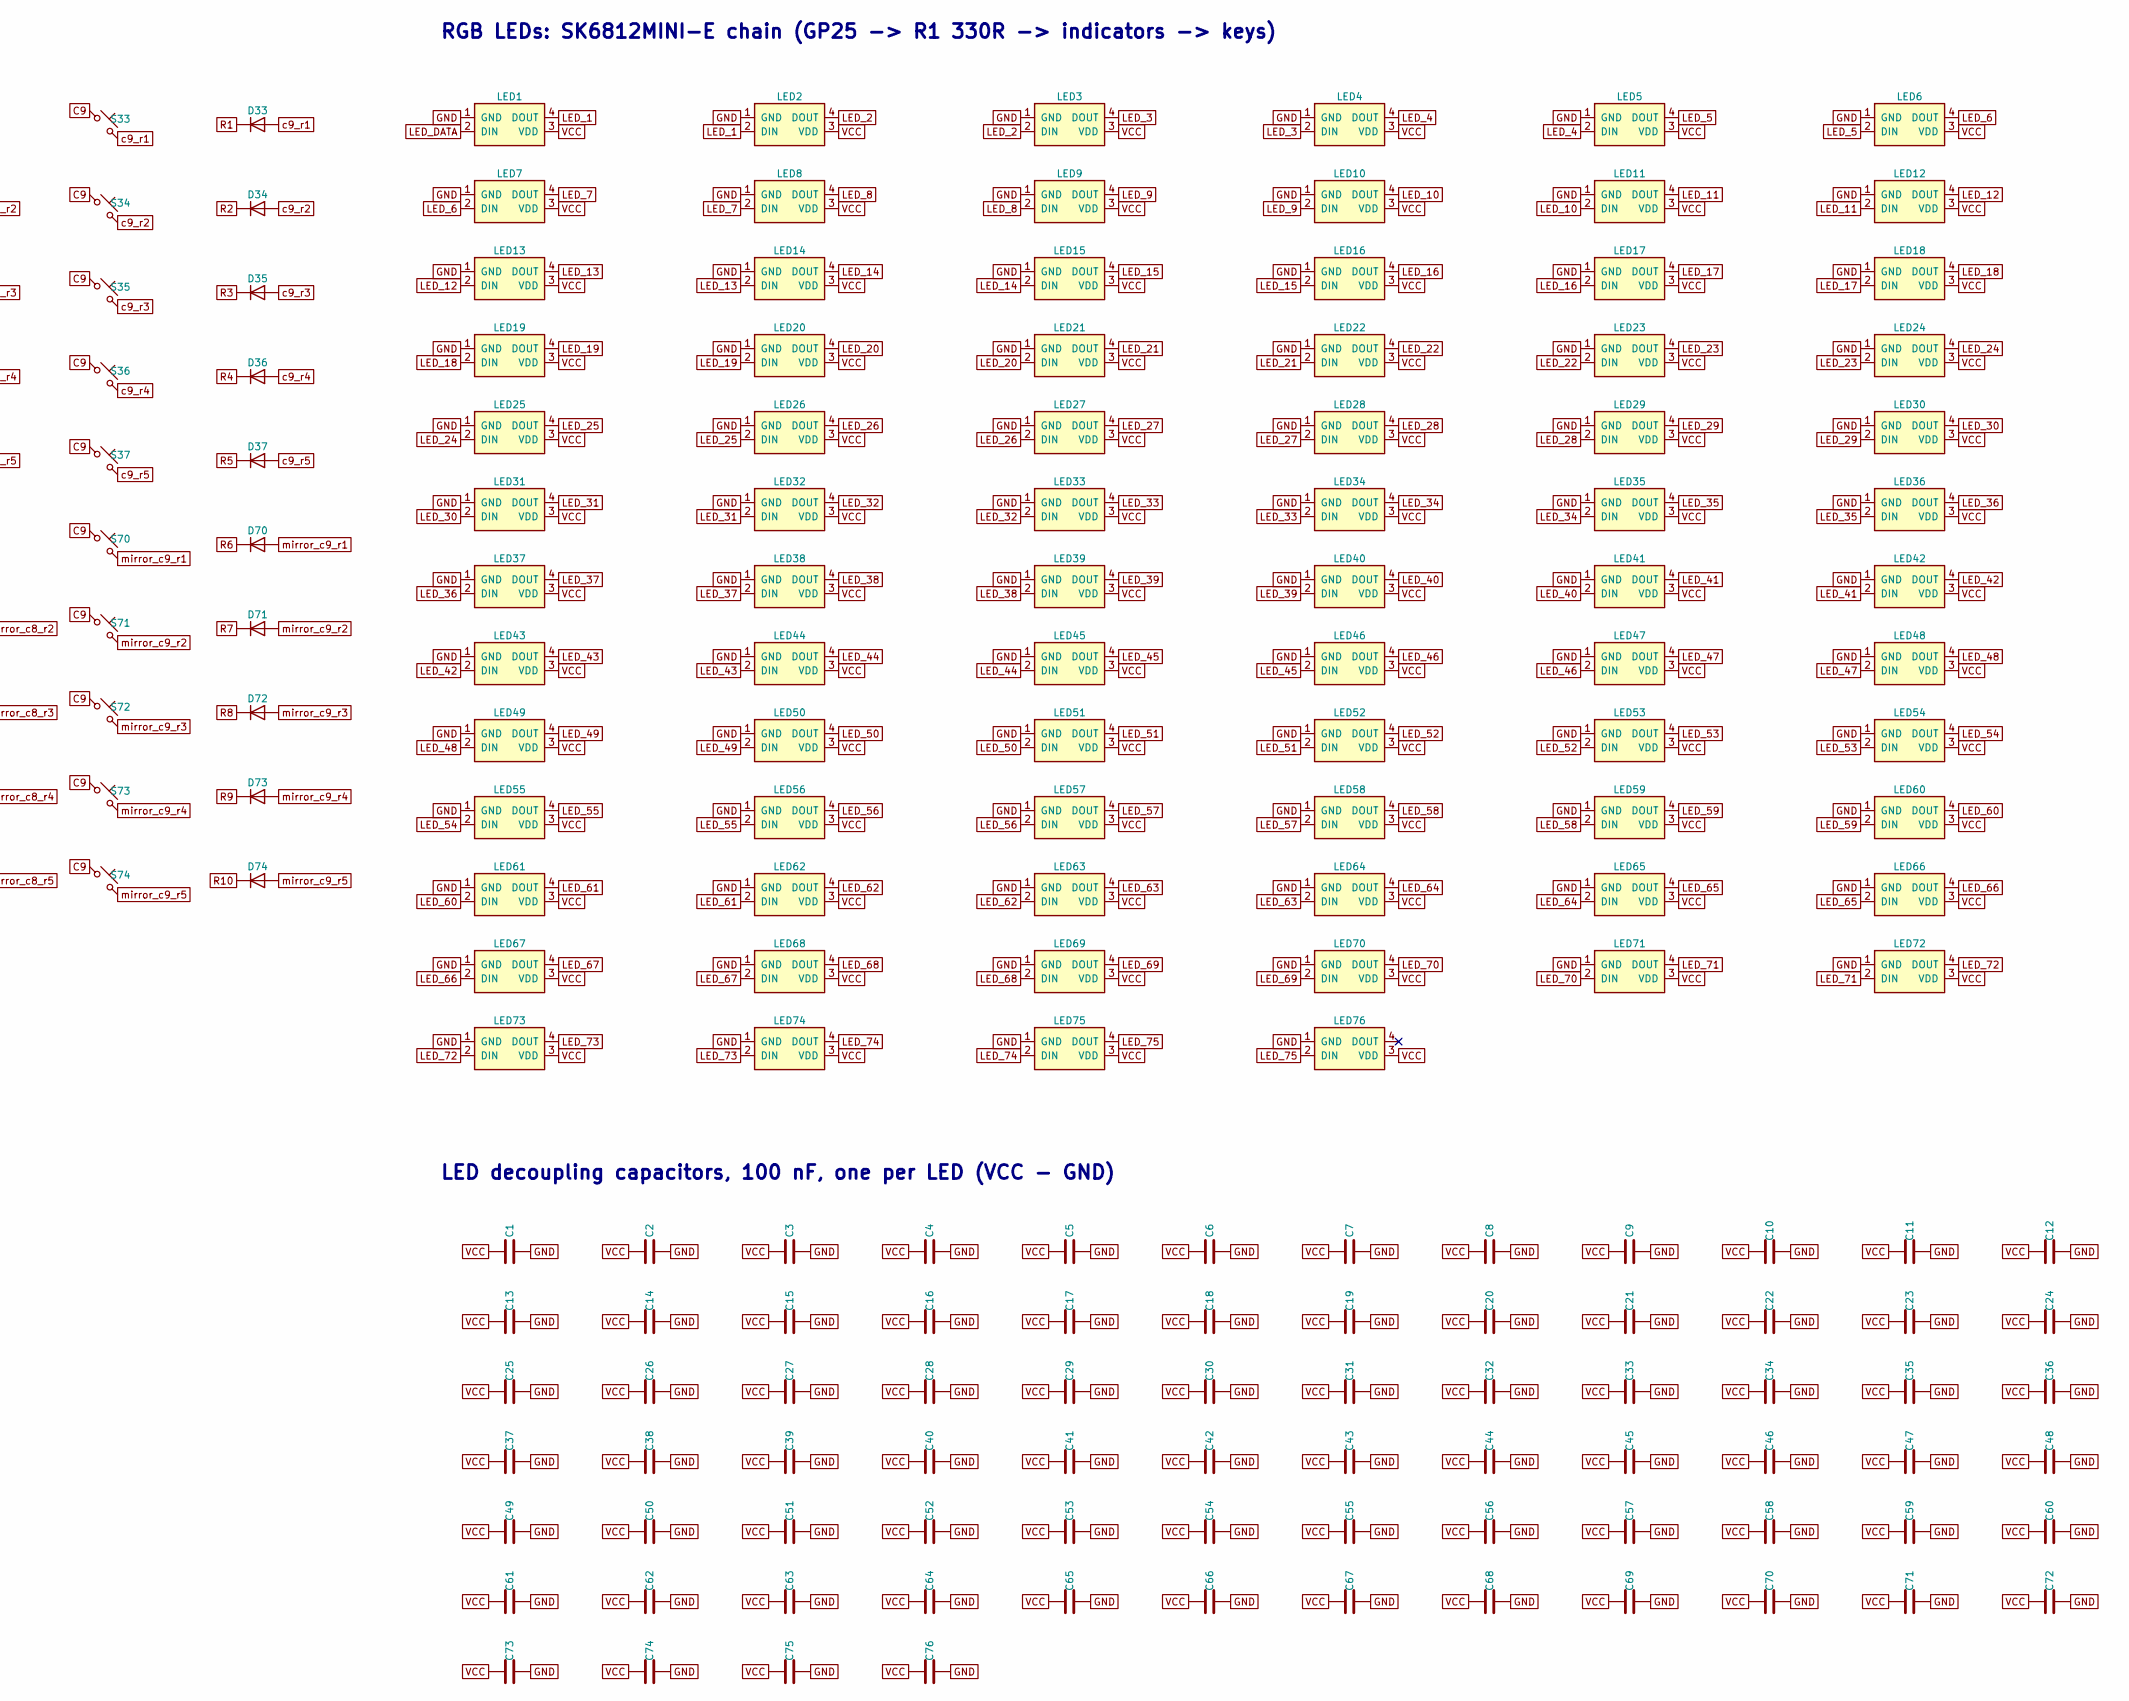
[picture p59: schematic hachigo74.kicad_sch, part in row 1, column 2]

Parts:
C1, C2, C3, C4, C5, C6, C7, C8, C9, C10, C11, C12, C13, C14, C15, C16, C17, C18, C19, C20, C21, C22, C23, C24, C25, C26, C27, C28, C29, C30, C31, C32, C33, C34, C35, C36, C37, C38, C39, C40, C41, C42, C43, C44, C45, C46, C47, C48, C49, C50, C51, C52, C53, C54, C55, C56, C57, C58, C59, C60, C61, C62, C63, C64, C65, C66, C67, C68, C69, C70, C71, C72, C73, C74, C75, C76: 100nF; C_0603; LCSC C14663
C77: 10uF; C_0805; LCSC C15850
D1, D2, D3, D4, D5, D6, D7, D8, D9, D10, D11, D12, D13, D14, D15, D16, D17, D18, D19, D20, D21, D22, D23, D24, D25, D26, D27, D28, D29, D30, D31, D32, D33, D34, D35, D36, D37, D38, D39, D40, D41, D42, D43, D44, D45, D46, D47, D48, D49, D50, D51, D52, D53, D54, D55, D56, D57, D58, D59, D60, D61, D62, D63, D64, D65, D66, D67, D68, D69, D70, D71, D72, D73, D74: 1N4148W; D_SOD-123; LCSC C81598
DISP1: SSD1306 0.96in; OLED_0.96in_SSD1306_I2C
J1: Molex_505278-1270; Molex_505278-1270_12p; LCSC C47149418
LED1, LED2, LED3, LED4, LED5, LED6, LED7, LED8, LED9, LED10, LED11, LED12, LED13, LED14, LED15, LED16, LED17, LED18, LED19, LED20, LED21, LED22, LED23, LED24, LED25, LED26, LED27, LED28, LED29, LED30, LED31, LED32, LED33, LED34, LED35, LED36, LED37, LED38, LED39, LED40, LED41, LED42, LED43, LED44, LED45, LED46, LED47, LED48, LED49, LED50, LED51, LED52, LED53, LED54, LED55, LED56, LED57, LED58, LED59, LED60, LED61, LED62, LED63, LED64, LED65, LED66, LED67, LED68, LED69, LED70, LED71, LED72, LED73, LED74, LED75, LED76: SK6812MINI-E; LED_SK6812MINI-E_Reverse; LCSC C5149201
MCU1: 0xCB Helios; 0xCB_Helios
R1: 330; R_0603; LCSC C23138
S1, S2, S3, S4, S5, S6, S7, S8, S9, S10, S11, S12, S13, S14, S16, S17, S18, S19, S20, S21, S22, S23, S25, S26, S27, S28, S29, S30, S31, S32, S34, S35, S36, S37, S38, S39, S40, S41, S42, S43, S44, S45, S46, S47, S48, S49, S50, S51, S53, S54, S55, S56, S57, S58, S59, S60, S62, S63, S64, S65, S66, S67, S68, S69, S71, S72, S73, S74: KS-33 1U; Gateron_KS-33_Hotswap_1U; LCSC C18212911
S15, S52: KS-33 2U + KS-57; Gateron_KS-33_Hotswap_2U_Stab_KS-57; LCSC C18212911
S24, S33, S61, S70: KS-33 1.25U; Gateron_KS-33_Hotswap_1.25U; LCSC C18212911
TP1: TM040040

Connections:
3V3: DISP1.2 (VCC), J1.12 (VDD), MCU1.16 (3V3), TP1.12 (VDD)
C2: MCU1.12 (GP9), S1.1, S2.1, S3.1, S4.1, S38.1, S39.1, S40.1, S41.1
C3: MCU1.25 (GP12), S5.1, S6.1, S7.1, S8.1, S9.1, S42.1, S43.1, S44.1, S45.1, S46.1
C4: MCU1.26 (GP13), S10.1, S11.1, S12.1, S13.1, S14.1, S47.1, S48.1, S49.1, S50.1, S51.1
C5: MCU1.27 (GP14), S15.1, S16.1, S17.1, S18.1, S19.1, S52.1, S53.1, S54.1, S55.1, S56.1
C6: MCU1.28 (GP15), S20.1, S21.1, S22.1, S23.1, S57.1, S58.1, S59.1, S60.1
C7: MCU1.29 (GP16), S24.1, S25.1, S26.1, S27.1, S28.1, S61.1, S62.1, S63.1, S64.1, S65.1
C8: MCU1.24 (GP21), S29.1, S30.1, S31.1, S32.1, S66.1, S67.1, S68.1, S69.1
C9: MCU1.23 (GP23), S33.1, S34.1, S35.1, S36.1, S37.1, S70.1, S71.1, S72.1, S73.1, S74.1
CIRQUE_DR: J1.4 (DR), MCU1.10 (GP7), TP1.4 (DR)
GND: C1.2, C2.2, C3.2, C4.2, C5.2, C6.2, C7.2, C8.2, C9.2, C10.2, C11.2, C12.2, C13.2, C14.2, C15.2, C16.2, C17.2, C18.2, C19.2, C20.2, C21.2, C22.2, C23.2, C24.2, C25.2, C26.2, C27.2, C28.2, C29.2, C30.2, C31.2, C32.2, C33.2, C34.2, C35.2, C36.2, C37.2, C38.2, C39.2, C40.2, C41.2, C42.2, C43.2, C44.2, C45.2, C46.2, C47.2, C48.2, C49.2, C50.2, C51.2, C52.2, C53.2, C54.2, C55.2, C56.2, C57.2, C58.2, C59.2, C60.2, C61.2, C62.2, C63.2, C64.2, C65.2, C66.2, C67.2, C68.2, C69.2, C70.2, C71.2, C72.2, C73.2, C74.2, C75.2, C76.2, C77.2, DISP1.1 (GND), J1.11 (GND), J1.13 (MP), J1.14 (MP), LED1.1 (GND), LED2.1 (GND), LED3.1 (GND), LED4.1 (GND), LED5.1 (GND), LED6.1 (GND), LED7.1 (GND), LED8.1 (GND), LED9.1 (GND), LED10.1 (GND), LED11.1 (GND), LED12.1 (GND), LED13.1 (GND), LED14.1 (GND), LED15.1 (GND), LED16.1 (GND), LED17.1 (GND), LED18.1 (GND), LED19.1 (GND), LED20.1 (GND), LED21.1 (GND), LED22.1 (GND), LED23.1 (GND), LED24.1 (GND), LED25.1 (GND), LED26.1 (GND), LED27.1 (GND), LED28.1 (GND), LED29.1 (GND), LED30.1 (GND), LED31.1 (GND), LED32.1 (GND), LED33.1 (GND), LED34.1 (GND), LED35.1 (GND), LED36.1 (GND), LED37.1 (GND), LED38.1 (GND), LED39.1 (GND), LED40.1 (GND), LED41.1 (GND), LED42.1 (GND), LED43.1 (GND), LED44.1 (GND), LED45.1 (GND), LED46.1 (GND), LED47.1 (GND), LED48.1 (GND), LED49.1 (GND), LED50.1 (GND), LED51.1 (GND), LED52.1 (GND), LED53.1 (GND), LED54.1 (GND), LED55.1 (GND), LED56.1 (GND), LED57.1 (GND), LED58.1 (GND), LED59.1 (GND), LED60.1 (GND), LED61.1 (GND), LED62.1 (GND), LED63.1 (GND), LED64.1 (GND), LED65.1 (GND), LED66.1 (GND), LED67.1 (GND), LED68.1 (GND), LED69.1 (GND), LED70.1 (GND), LED71.1 (GND), LED72.1 (GND), LED73.1 (GND), LED74.1 (GND), LED75.1 (GND), LED76.1 (GND), MCU1.3 (GND), MCU1.4 (GND), MCU1.14 (GND), TP1.11 (GND)
LED_1: LED1.4 (DOUT), LED2.2 (DIN)
LED_2: LED2.4 (DOUT), LED3.2 (DIN)
LED_3: LED3.4 (DOUT), LED4.2 (DIN)
LED_4: LED4.4 (DOUT), LED5.2 (DIN)
LED_5: LED5.4 (DOUT), LED6.2 (DIN)
LED_6: LED6.4 (DOUT), LED7.2 (DIN)
LED_7: LED7.4 (DOUT), LED8.2 (DIN)
LED_8: LED8.4 (DOUT), LED9.2 (DIN)
LED_9: LED9.4 (DOUT), LED10.2 (DIN)
LED_10: LED10.4 (DOUT), LED11.2 (DIN)
LED_11: LED11.4 (DOUT), LED12.2 (DIN)
LED_12: LED12.4 (DOUT), LED13.2 (DIN)
LED_13: LED13.4 (DOUT), LED14.2 (DIN)
LED_14: LED14.4 (DOUT), LED15.2 (DIN)
LED_15: LED15.4 (DOUT), LED16.2 (DIN)
LED_16: LED16.4 (DOUT), LED17.2 (DIN)
LED_17: LED17.4 (DOUT), LED18.2 (DIN)
LED_18: LED18.4 (DOUT), LED19.2 (DIN)
LED_19: LED19.4 (DOUT), LED20.2 (DIN)
LED_20: LED20.4 (DOUT), LED21.2 (DIN)
LED_21: LED21.4 (DOUT), LED22.2 (DIN)
LED_22: LED22.4 (DOUT), LED23.2 (DIN)
LED_23: LED23.4 (DOUT), LED24.2 (DIN)
LED_24: LED24.4 (DOUT), LED25.2 (DIN)
LED_25: LED25.4 (DOUT), LED26.2 (DIN)
LED_26: LED26.4 (DOUT), LED27.2 (DIN)
LED_27: LED27.4 (DOUT), LED28.2 (DIN)
LED_28: LED28.4 (DOUT), LED29.2 (DIN)
LED_29: LED29.4 (DOUT), LED30.2 (DIN)
LED_30: LED30.4 (DOUT), LED31.2 (DIN)
LED_31: LED31.4 (DOUT), LED32.2 (DIN)
LED_32: LED32.4 (DOUT), LED33.2 (DIN)
LED_33: LED33.4 (DOUT), LED34.2 (DIN)
LED_34: LED34.4 (DOUT), LED35.2 (DIN)
LED_35: LED35.4 (DOUT), LED36.2 (DIN)
LED_36: LED36.4 (DOUT), LED37.2 (DIN)
LED_37: LED37.4 (DOUT), LED38.2 (DIN)
LED_38: LED38.4 (DOUT), LED39.2 (DIN)
LED_39: LED39.4 (DOUT), LED40.2 (DIN)
LED_40: LED40.4 (DOUT), LED41.2 (DIN)
LED_41: LED41.4 (DOUT), LED42.2 (DIN)
LED_42: LED42.4 (DOUT), LED43.2 (DIN)
LED_43: LED43.4 (DOUT), LED44.2 (DIN)
LED_44: LED44.4 (DOUT), LED45.2 (DIN)
LED_45: LED45.4 (DOUT), LED46.2 (DIN)
LED_46: LED46.4 (DOUT), LED47.2 (DIN)
LED_47: LED47.4 (DOUT), LED48.2 (DIN)
LED_48: LED48.4 (DOUT), LED49.2 (DIN)
LED_49: LED49.4 (DOUT), LED50.2 (DIN)
LED_50: LED50.4 (DOUT), LED51.2 (DIN)
LED_51: LED51.4 (DOUT), LED52.2 (DIN)
LED_52: LED52.4 (DOUT), LED53.2 (DIN)
LED_53: LED53.4 (DOUT), LED54.2 (DIN)
LED_54: LED54.4 (DOUT), LED55.2 (DIN)
LED_55: LED55.4 (DOUT), LED56.2 (DIN)
LED_56: LED56.4 (DOUT), LED57.2 (DIN)
LED_57: LED57.4 (DOUT), LED58.2 (DIN)
LED_58: LED58.4 (DOUT), LED59.2 (DIN)
LED_59: LED59.4 (DOUT), LED60.2 (DIN)
LED_60: LED60.4 (DOUT), LED61.2 (DIN)
LED_61: LED61.4 (DOUT), LED62.2 (DIN)
LED_62: LED62.4 (DOUT), LED63.2 (DIN)
LED_63: LED63.4 (DOUT), LED64.2 (DIN)
LED_64: LED64.4 (DOUT), LED65.2 (DIN)
LED_65: LED65.4 (DOUT), LED66.2 (DIN)
LED_66: LED66.4 (DOUT), LED67.2 (DIN)
LED_67: LED67.4 (DOUT), LED68.2 (DIN)
LED_68: LED68.4 (DOUT), LED69.2 (DIN)
LED_69: LED69.4 (DOUT), LED70.2 (DIN)
LED_70: LED70.4 (DOUT), LED71.2 (DIN)
LED_71: LED71.4 (DOUT), LED72.2 (DIN)
LED_72: LED72.4 (DOUT), LED73.2 (DIN)
LED_73: LED73.4 (DOUT), LED74.2 (DIN)
LED_74: LED74.4 (DOUT), LED75.2 (DIN)
LED_75: LED75.4 (DOUT), LED76.2 (DIN)
LED_DATA: LED1.2 (DIN), R1.2
LED_DATA_MCU: MCU1.34 (GP25), R1.1
R1: D1.1 (K), D5.1 (K), D10.1 (K), D15.1 (K), D24.1 (K), D33.1 (K), MCU1.21 (GP22)
R2: D2.1 (K), D6.1 (K), D11.1 (K), D16.1 (K), D20.1 (K), D25.1 (K), D29.1 (K), D34.1 (K), MCU1.20 (GP26)
R3: D3.1 (K), D7.1 (K), D12.1 (K), D17.1 (K), D21.1 (K), D26.1 (K), D30.1 (K), D35.1 (K), MCU1.19 (GP27)
R4: D4.1 (K), D8.1 (K), D13.1 (K), D18.1 (K), D22.1 (K), D27.1 (K), D31.1 (K), D36.1 (K), MCU1.18 (GP28)
R5: D9.1 (K), D14.1 (K), D19.1 (K), D23.1 (K), D28.1 (K), D32.1 (K), D37.1 (K), MCU1.17 (GP29)
R6: D38.1 (K), D42.1 (K), D47.1 (K), D52.1 (K), D61.1 (K), D70.1 (K), MCU1.9 (GP6)
R7: D39.1 (K), D43.1 (K), D48.1 (K), D53.1 (K), D57.1 (K), D62.1 (K), D66.1 (K), D71.1 (K), MCU1.8 (GP5)
R8: D40.1 (K), D44.1 (K), D49.1 (K), D54.1 (K), D58.1 (K), D63.1 (K), D67.1 (K), D72.1 (K), MCU1.7 (GP4)
R9: D41.1 (K), D45.1 (K), D50.1 (K), D55.1 (K), D59.1 (K), D64.1 (K), D68.1 (K), D73.1 (K), MCU1.2 (GP1)
R10: D46.1 (K), D51.1 (K), D56.1 (K), D60.1 (K), D65.1 (K), D69.1 (K), D74.1 (K), MCU1.1 (GP0)
SCL: DISP1.3 (SCL), J1.9 (SCL), MCU1.6 (GP3), TP1.9 (SCL)
SDA: DISP1.4 (SDA), J1.10 (SDA), MCU1.5 (GP2), TP1.10 (SDA)
TP_BTN1: J1.8 (B1), TP1.8 (B1)
TP_BTN2: J1.6 (B2), TP1.6 (B2)
TP_BTN3: J1.7 (B3), TP1.7 (B3)
TP_MISO: J1.2 (SO), TP1.2 (SO)
TP_MOSI: J1.5 (SI), TP1.5 (SI)
TP_SCK: J1.1 (SCK), TP1.1 (SCK)
TP_SS: J1.3 (SS), TP1.3 (SS)
VCC: C1.1, C2.1, C3.1, C4.1, C5.1, C6.1, C7.1, C8.1, C9.1, C10.1, C11.1, C12.1, C13.1, C14.1, C15.1, C16.1, C17.1, C18.1, C19.1, C20.1, C21.1, C22.1, C23.1, C24.1, C25.1, C26.1, C27.1, C28.1, C29.1, C30.1, C31.1, C32.1, C33.1, C34.1, C35.1, C36.1, C37.1, C38.1, C39.1, C40.1, C41.1, C42.1, C43.1, C44.1, C45.1, C46.1, C47.1, C48.1, C49.1, C50.1, C51.1, C52.1, C53.1, C54.1, C55.1, C56.1, C57.1, C58.1, C59.1, C60.1, C61.1, C62.1, C63.1, C64.1, C65.1, C66.1, C67.1, C68.1, C69.1, C70.1, C71.1, C72.1, C73.1, C74.1, C75.1, C76.1, C77.1, LED1.3 (VDD), LED2.3 (VDD), LED3.3 (VDD), LED4.3 (VDD), LED5.3 (VDD), LED6.3 (VDD), LED7.3 (VDD), LED8.3 (VDD), LED9.3 (VDD), LED10.3 (VDD), LED11.3 (VDD), LED12.3 (VDD), LED13.3 (VDD), LED14.3 (VDD), LED15.3 (VDD), LED16.3 (VDD), LED17.3 (VDD), LED18.3 (VDD), LED19.3 (VDD), LED20.3 (VDD), LED21.3 (VDD), LED22.3 (VDD), LED23.3 (VDD), LED24.3 (VDD), LED25.3 (VDD), LED26.3 (VDD), LED27.3 (VDD), LED28.3 (VDD), LED29.3 (VDD), LED30.3 (VDD), LED31.3 (VDD), LED32.3 (VDD), LED33.3 (VDD), LED34.3 (VDD), LED35.3 (VDD), LED36.3 (VDD), LED37.3 (VDD), LED38.3 (VDD), LED39.3 (VDD), LED40.3 (VDD), LED41.3 (VDD), LED42.3 (VDD), LED43.3 (VDD), LED44.3 (VDD), LED45.3 (VDD), LED46.3 (VDD), LED47.3 (VDD), LED48.3 (VDD), LED49.3 (VDD), LED50.3 (VDD), LED51.3 (VDD), LED52.3 (VDD), LED53.3 (VDD), LED54.3 (VDD), LED55.3 (VDD), LED56.3 (VDD), LED57.3 (VDD), LED58.3 (VDD), LED59.3 (VDD), LED60.3 (VDD), LED61.3 (VDD), LED62.3 (VDD), LED63.3 (VDD), LED64.3 (VDD), LED65.3 (VDD), LED66.3 (VDD), LED67.3 (VDD), LED68.3 (VDD), LED69.3 (VDD), LED70.3 (VDD), LED71.3 (VDD), LED72.3 (VDD), LED73.3 (VDD), LED74.3 (VDD), LED75.3 (VDD), LED76.3 (VDD), MCU1.13 (5V)
c2_r1: D1.2 (A), S1.2
c2_r2: D2.2 (A), S2.2
c2_r3: D3.2 (A), S3.2
c2_r4: D4.2 (A), S4.2
c3_r1: D5.2 (A), S5.2
c3_r2: D6.2 (A), S6.2
c3_r3: D7.2 (A), S7.2
c3_r4: D8.2 (A), S8.2
c3_r5: D9.2 (A), S9.2
c4_r1: D10.2 (A), S10.2
c4_r2: D11.2 (A), S11.2
c4_r3: D12.2 (A), S12.2
c4_r4: D13.2 (A), S13.2
c4_r5: D14.2 (A), S14.2
c5_r1: D15.2 (A), S15.2
c5_r2: D16.2 (A), S16.2
c5_r3: D17.2 (A), S17.2
c5_r4: D18.2 (A), S18.2
c5_r5: D19.2 (A), S19.2
c6_r2: D20.2 (A), S20.2
c6_r3: D21.2 (A), S21.2
c6_r4: D22.2 (A), S22.2
c6_r5: D23.2 (A), S23.2
c7_r1: D24.2 (A), S24.2
c7_r2: D25.2 (A), S25.2
c7_r3: D26.2 (A), S26.2
c7_r4: D27.2 (A), S27.2
c7_r5: D28.2 (A), S28.2
c8_r2: D29.2 (A), S29.2
c8_r3: D30.2 (A), S30.2
c8_r4: D31.2 (A), S31.2
c8_r5: D32.2 (A), S32.2
c9_r1: D33.2 (A), S33.2
c9_r2: D34.2 (A), S34.2
c9_r3: D35.2 (A), S35.2
c9_r4: D36.2 (A), S36.2
c9_r5: D37.2 (A), S37.2
mirror_c2_r1: D38.2 (A), S38.2
mirror_c2_r2: D39.2 (A), S39.2
mirror_c2_r3: D40.2 (A), S40.2
mirror_c2_r4: D41.2 (A), S41.2
mirror_c3_r1: D42.2 (A), S42.2
mirror_c3_r2: D43.2 (A), S43.2
mirror_c3_r3: D44.2 (A), S44.2
mirror_c3_r4: D45.2 (A), S45.2
mirror_c3_r5: D46.2 (A), S46.2
mirror_c4_r1: D47.2 (A), S47.2
mirror_c4_r2: D48.2 (A), S48.2
mirror_c4_r3: D49.2 (A), S49.2
mirror_c4_r4: D50.2 (A), S50.2
mirror_c4_r5: D51.2 (A), S51.2
mirror_c5_r1: D52.2 (A), S52.2
mirror_c5_r2: D53.2 (A), S53.2
mirror_c5_r3: D54.2 (A), S54.2
mirror_c5_r4: D55.2 (A), S55.2
mirror_c5_r5: D56.2 (A), S56.2
mirror_c6_r2: D57.2 (A), S57.2
mirror_c6_r3: D58.2 (A), S58.2
mirror_c6_r4: D59.2 (A), S59.2
mirror_c6_r5: D60.2 (A), S60.2
mirror_c7_r1: D61.2 (A), S61.2
mirror_c7_r2: D62.2 (A), S62.2
mirror_c7_r3: D63.2 (A), S63.2
mirror_c7_r4: D64.2 (A), S64.2
mirror_c7_r5: D65.2 (A), S65.2
mirror_c8_r2: D66.2 (A), S66.2
mirror_c8_r3: D67.2 (A), S67.2
mirror_c8_r4: D68.2 (A), S68.2
mirror_c8_r5: D69.2 (A), S69.2
mirror_c9_r1: D70.2 (A), S70.2
mirror_c9_r2: D71.2 (A), S71.2
mirror_c9_r3: D72.2 (A), S72.2
mirror_c9_r4: D73.2 (A), S73.2
mirror_c9_r5: D74.2 (A), S74.2

Notes on the sheet:
Trackpad: Cirque TM040040 (I2C 0x2A, R1 removed),
RGB LEDs: SK6812MINI-E chain (GP25 -> R1 330R -> indicators -> keys)
LED data resistor, bulk capacitor
OLED 0.96in SSD1306 (I2C 0x3C)
Key matrix (COL2ROW): columns C2-C9, rows R1-R10 (left half R1-R5, right half R6-R10); value = switch / keycap size
LED decoupling capacitors, 100 nF, one per LED (VCC - GND)
Power flags
MCU: 0xCB Helios (RP2040)
12-pin 0.5 mm Type D FFC, pin n = pin n

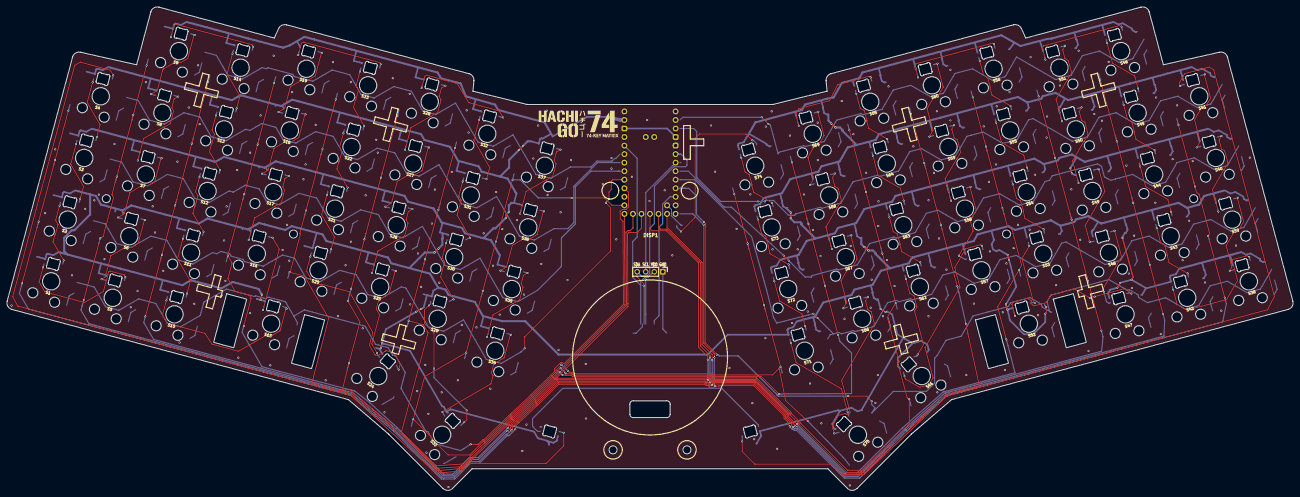
[picture p60: board hachigo74.kicad_pcb from above]

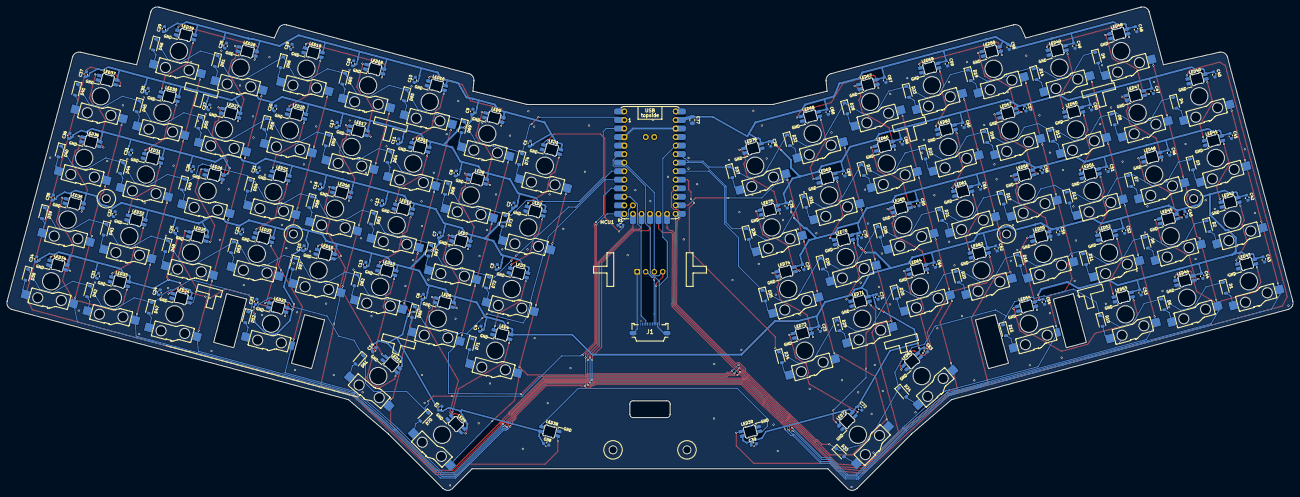
[picture p61: board hachigo74.kicad_pcb from below]

Board: 2 copper layers, 382.7 x 143.8 mm, 307 parts (304 on the bottom side), 175 nets.

Other parts of the board:
LOGO1: Logo_hachigo74
MECH1: Cirque_TM040040_3D
