baalsmn/kbd-workshop/(commit log)

2026-10-17 keyboard-workshop: shared tools + kugo and hachigo74 keyboards
    Root holds the shared tools, footprints, 3D models, datasheets and DRC rules;
    kugo/ (kugo82 current, kugo80 backup) and hachigo74/ hold each keyboard's
    yaml, KLE, case STL/STEP/Fusion data and renders. Adds the Fusion script
    (tools/fusion/KeyboardCase) and its data export (tools/lib/fusion_data.py).
    [Diode_SOD-123.step, Helios_0xCB_rev1.0.step, center_cover.step, center_cover.stl, lid_left.step, lid_left.stl, lid_right.step, lid_right.stl]
2026-10-17 Fusion script: one sketch per loop depth instead of bbox profile matching
    Fusion's profile bounding boxes are loose on arcs, so most outlines found no
    matching profile. Filled loops and holes now go into separate sketches
    (extrude new body, then cut), and the root component is no longer renamed.
    Known open issue: kugo82 lid shows a fault at the top-left concave corner.
2026-10-17 Fusion script: optional plate ribs around the switch cutouts
    Asked at start (depth, relief gap, width; default 1.0, 1.0, 1.5): a rib frame
    under the switch plate around every switch cutout, with a relief gap so the
    switches and KS-57 stabilizers still snap in (2U keys: around switch + stab
    housings + wire). Neighbouring frames merge into a web. Clipped 0.5 mm inside
    the PCB outline, plate holes cut through; depth is the user parameter
    plate_rib (max 1.3 = PCB top). fusion_data.py exports the key rectangles and
    the rib region for both designs. Ran without errors in Fusion.
2026-10-17 hachigo74: crosses moved from c4_r3/c4_r4 to c3_r4/c6_r4
    Upper right corners now c4_r1, c3_r4, c6_r4, c8_r3 + c7_r1 top middle (user's
    choice). c6_r4 gets only an upper cross (T, east blocked); its lower corner is
    blocked like c8_r3. crosses.py takes the design's cross list as an optional
    4th argument. DRC unchanged (2 silk_overlap); STL, STEP and Fusion data
    regenerated.
    [lid_left.step, lid_left.stl, lid_right.step, lid_right.stl, tub_left.step, tub_left.stl, tub_right.step, tub_right.stl]
2026-10-17 hachigo74: cross at c7_r4, drop crosses without lower support
    Crosses now c4_r1, c3_r4, c7_r4 (upper right) + c7_r1 top middle, each with a
    lower and an upper part. c6_r4 and c8_r3 removed (their lower corner is
    blocked, so they had only the upper cross). DRC unchanged (2 silk_overlap);
    STL, STEP and Fusion data regenerated.
    [lid_left.step, lid_left.stl, lid_right.step, lid_right.stl, tub_left.step, tub_left.stl, tub_right.step, tub_right.stl]
2026-10-17 Trackpad pin 1 verified; kicad project folder started
    From the user's photos of the real TM040040 (drafts/): the module's J1 pin 1
    is at the east end, as is Molex J1 pin 1 on the board, so pin n = pin n holds.
    Notes the R1 removal needed for I2C mode, fixes the stale trackpad comment in
    both yamls (comments only, board unchanged), and adds kicad project/ (the
    final self-contained KiCad project; Helios symbol library so far).
    [hachigo74.yaml, kugo82.yaml]
2026-10-17 kicad project: self-contained symbol, footprint and 3D model library
    Footprints exported from the built boards exactly as placed (KS-33 hot-swap
    1U/1.25U/2U+KS-57, SOD-123, SK6812MINI-E reverse, 0603/0805, Helios, Molex,
    OLED, trackpad 3D, logo) with their 3D models, all ${KIPRJMOD}-relative.
    Symbols copied from KiCad's built-in libraries with our pinouts, prefixes and
    footprints; project sym/fp-lib-tables. Helios symbol renumbered to the 0xCB
    pad numbers, SK6812MINI-E symbol renumbered to the footprint (datasheet)
    numbering; every symbol/footprint pair checked pin for pin. Adds the
    generator scripts and the user's vendor footprints (keyboard.pretty).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
    [C_0603_1608Metric.step, C_0805_2012Metric.step, Diode_SOD-123.step, Helios_0xCB_rev1.0.step, R_0603_1608Metric.step]
2026-10-17 SK6812MINI-E: pin numbers per the C5149201 datasheet, JLCPCB-style symbol
    The OPSCO datasheet (LCSC/JLCPCB C5149201, now in datasheets/) numbers the
    pins 1 GND, 2 DIN, 3 VDD, 4 DOUT. The footprint pads are renumbered to it;
    positions and nets are unchanged (checked on all 76 hachigo74 LEDs; DRC
    unchanged on both boards). The library symbol is drawn as on JLCPCB's part
    page with an LCSC field. Helios symbol: GND pins 3/4 left, 14 right, labels
    moved off the pins. CLAUDE.md: LED current is 12 mA per colour (~3.1 A full
    white for kugo82, not 5 A), VIH 0.65 x VDD (5 V level-shifted data needed).
2026-10-17 hachigo74 KiCad project; one symbol library; kicad libraries folder
    hachigo74/kicad: portable KiCad project (PCB from the Ergogen build, schematic
    generated from its netlist, .kicad_dru, project copy of the libraries, all
    paths ${KIPRJMOD}/libraries/...). Verified: ERC 0, DRC schematic parity 0,
    schematic netlist = Ergogen board on all 808 pads. Unused pins get no-connect
    flags; footprints carry the symbol fields.
    Symbol libraries merged into keyboard-workshop.kicad_sym (Helios included,
    hand-added symbols kept on regeneration); kicad project/ renamed to
    kicad libraries/ by the user. Fixes the 3D model path rewrite in the library
    export (pcbnew Models() must be edited by index). Shared help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
    [C_0603_1608Metric.step, C_0805_2012Metric.step, Diode_SOD-123.step, Helios_0xCB_rev1.0.step, R_0603_1608Metric.step, hachigo74.kicad_sch]
2026-10-17 README: kicad libraries and the hachigo74 KiCad project
2026-10-18 hachigo74: PCB outline follows the 1.25U Esc keycap; 1:1 print layout
    The outline corner above c3_r5 (1.25U Esc) and the step point at c2_r4 were
    placed for a 1U key, so the Esc keycap came within 0.02 mm of the PCB edge;
    now -0.625sp in the Esc frame, every keycap keeps 2.40 mm. The case-wall
    insert hole at that corner moves with it (2.90 / 3.50 mm wall). Case STL /
    STEP / Fusion data regenerated; DRC unchanged.
    tools/lib/printview.py: 1:1 vector PDF of the layout on two A4 sheets
    (hachigo74/hachigo74_layout_1to1.pdf). tools/lib/kicad_outline_sync.py:
    carries Edge.Cuts changes into an edited KiCad project board (not applied;
    the KiCad project is updated only on request).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
    [lid_left.step, lid_left.stl, lid_right.step, lid_right.stl, tub_left.step, tub_left.stl, tub_right.step, tub_right.stl]
2026-10-18 hachigo74 KiCad project: user's layout (rotated 15 deg, routed); ignore .history
    The user's own work in KiCad: the layout rotated 15 degrees, routing (1
    connection left), JLCPCB-style design rules in the project file. KiCad's
    local history folder is ignored.
2026-10-18 hachigo74: thumb key, angled c7_r1, 1U Esc, keycap-hugging outline, Claude Code logo
    - c9_r1 becomes a thumb key at the old interstate design's thumb-zone 'one'
    position relative to c9_r2 ([-8.805, -28.245] mm, -30 deg; adjust, so r2..r5
    stay put).
    - c7: no stagger (level with c6, c8 takes the -0.25sp); c7_r1 1.25U without
    stabilizer, angled so its keycap bottom edge lies on the line from the c5_r1
    to the c9_r1 keycap corners (-25.6 deg, 2.17 mm gaps).
    - c3_r5 (Esc) 1U, in line with column 3.
    - Indicator LEDs back at their old place, anchored on c9_r2.
    - PCB outline on the keycap corners: 2.00 mm from every edge keycap; bottom
    bridge at the middle of the thumb keys' inner edges, to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
2026-10-18 hachigo74: case files and renders for the new layout; exact KLE export
    - Case STL / STEP / Fusion data regenerated for the thumb key, angled c7_r1,
    1U Esc and keycap-hugging outline (STL and STEP volumes within 1 %).
    - 3D renders (iso, top, centre) with keycaps.
    - tools/lib/kle_export.py: exact KLE layout from the Ergogen build (per-key
    r / rx / ry, 1U = 19 mm, labels by key name via hachigo74/kle/hachigo74_keys.json);
    hachigo74/kle/hachigo74_exact.json read back within 0.0002 mm, angles exact.
    [center_cover.step, lid_left.step, lid_left.stl, lid_right.step, lid_right.stl, oled_spacers.step, trackpad_ring.step, tub_left.step]
2026-10-18 Licensing cleanup: LICENSE files, datasheet links, recreated 3D models, no logos
    - LICENSE (hardware CERN-OHL-S-2.0, scripts GPL-3.0-or-later), LICENSES/ texts,
    THIRD_PARTY_NOTICES.md (KiCad libs CC-BY-SA-4.0, 0xCB Helios CERN-OHL-S-2.0,
    ceoloide MIT); datasheets/LINKS.md with sources.
    - 3D models of bought parts recreated from datasheet dimensions
    (tools/lib/make_models.py: KS-33 switch, KS-2P02B01-02 socket, KS-57
    stabilizer, SK6812MINI-E, Molex 505278, Cirque TM040040), in the vendor
    models' frames. Vendor models and footprints of unknown licence moved to
    gitignored folders; sea-picro.step removed.
    - KS-33 / KS-57 footprint geometry documented from the Gateron drawings; all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
    [Cirque_TM040040.step, Gateron_KS-2P02B01-02_socket.step, Gateron_KS-33_switch.step, Gateron_KS-57_stabilizer.step, Molex_505278-1270.step, SK6812MINI-E.step]
2026-10-18 Molex 505278 footprint and model documented from the Molex sales drawing
    Adds the official sales drawing 5052781004 (5052781270_sd.pdf) to datasheets/.
    The footprint already matched its recommended PCB pattern exactly (signal pads
    0.30 x 1.0 at 0.5 pitch, fitting nails 2.0 x 1.3 at +-5.05 / +0.275); pads
    unchanged on both boards.
2026-10-18 Consolidate 3D models into kicad libraries/3dmodels; drop keyboard.pretty
    - kicad libraries/3dmodels/ is now the only home of the 3D models: the Ergogen
    footprints, the yamls, render.sh and make_models.py use it directly (3dmodels/
    held byte-identical copies). The 0603 / 0805 models no longer come from the
    KiCad install, so the repo is self-contained.
    - keyboard.pretty/ (0xCB Helios reference footprints, unused by the build)
    removed; helios.js credits 0xCB's repository.
    - Local vendor reference copies gathered in vendor/ (gitignored).
    - Two draft sketches removed (deleted by the user).
    All designs build; every model path resolves (kugo80 16, kugo82 / hachigo74 15).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
    [Cirque_TM040040.step, Diode_SOD-123.step, Gateron_KS-2P02B01-02_socket.step, Gateron_KS-33_switch.step, Gateron_KS-57_stabilizer.step, Helios_0xCB_rev1.0.step, Molex_505278-1270.step, SK6812MINI-E.step]
2026-10-18 Move Ergogen inputs to ergogen/, rename kicad libraries -> kicad-libraries
    - ergogen/ holds the three design yamls and footprints/; keyboard folders keep
    their outputs (kle/, case/, renders/). Each yaml's first line
    "# keyboard: <folder>" tells tools/lib/design.sh where outputs go.
    - "kicad libraries" renamed to kicad-libraries; all paths updated.
    - Builds unchanged (same DRC, identical hachigo74 board and STLs).
    [C_0603_1608Metric.step, C_0805_2012Metric.step, Cirque_TM040040.step, Diode_SOD-123.step, Gateron_KS-2P02B01-02_socket.step, Gateron_KS-33_switch.step, Gateron_KS-57_stabilizer.step, Helios_0xCB_rev1.0.step]
2026-10-18 hachigo74: Japanese (JIS) KLE layout
    hachigo74_jis_keys.json (key name -> JIS legends) and its exact export
    hachigo74_jis.json (Ergogen positions and angles). Kana switching keys:
    半角/全角 (GRV), 無変換 (INT5), 変換 (INT4), かな (INT2), plus 英数 (CAPS).
2026-10-18 JLCPCB: LCSC fields and assembly exclusions; regenerate hachigo74 KiCad project
    - Ergogen footprints carry a hidden LCSC field (param lcsc), checked on
    jlcpcb.com: C14663 100nF 0603, C15850 10uF 0805, C23138 330R 0603,
    C81598 1N4148W, C5149201 SK6812MINI-E, C47149418 Molex 505278-1270,
    C18212911 Gateron KS-2P02B01-02 socket (switch footprint now attr smd).
    - OLED excluded from BOM and position files (hand-mounted).
    - kicad_project.py copies the footprint LCSC into the schematic symbol;
    kicad-libraries footprints re-exported.
    - hachigo74/kicad regenerated from the current layout (overwrites the old
    routed board, still in 5a3f27c); keeps the solder mask clearance 0.005
    setting and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
    [hachigo74.kicad_sch]
2026-10-19 JLC assembly panel with KiKit; ignore Fabrication Toolkit output
    - tools/panel.sh: KiKit panel of a design's project board (5 mm rails top
    and bottom, mouse-bite tabs, tooling holes, fiducials, JLCJLCJLCJLC);
    KiKit in its own venv on KiCad's Python.
    - tools/lib/panel_tabs.py: tabs at fixed x positions where the outline
    reaches the rails; hachigo74/panel.json is the recipe.
    - tools/lib/snap_outline.py: closes Ergogen's sub-micron outline gaps in a
    temp copy (KiKit rejects them).
    - Panel DRC rule for the LED windows (KiKit moves footprint cutouts into the
    outline). hachigo74/kicad/hachigo74_panel.* generated.
    - .gitignore: kicad/production/.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
    [hachigo74_panel.kicad_pcb]
2026-10-19 kugo82 rebuilt as the larger hachigo74; old kugo / kugo80 removed
    - ergogen/kugo82.yaml: hachigo74 plus the outer column c1 and the original
    kugo82 c1-c4 (1.25U c2_r3, c2_r4, c3_r2, c3_r5, c4_r1); thumbs, angled
    c7_r1, centre, outline (2 mm from every keycap), screws as hachigo74.
    84 LEDs, column C1 used again.
    - Crosses: c1_r1, c1_r3, c4_r1 (1.25U corner), c3_r4, c7_r4, c8_r2.
    - kugo82/: KLE (keys map, exact export, legends), case STL / STEP / Fusion
    data, portable KiCad project (ERC 0, parity clean), assembly panel.
    - kugo/ and ergogen/kugo80.yaml removed; shared hardware notes moved to
    kugo82/CLAUDE.md; tools and docs point to kugo82/.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
    [center_cover.step, center_cover.stl, kugo82.kicad_pcb, kugo82.kicad_sch, kugo82_panel.kicad_pcb, lid_left.step, lid_left.stl, lid_right.step]
2026-10-19 Track width DRC rules; JLC-compliant assembly panels with frame and bridges
    - keyboard.kicad_dru (and the project / panel copies): track widths, min /
    router default: signals 0.2 / 0.25 mm, VCC 0.3 / 1.0 mm, GND 0.5 / 1.0 mm,
    3V3 0.3 / 0.4 mm; nets matched by their end so panel nets match too.
    - Panels follow JLC's edge rail / fiducial guideline: 9 mm top / bottom
    rails, fiducials (1 mm, 2 mm opening, both sides) centred so the keep-out
    is 3.5 mm from every edge; 5 mm side rails (RailsFrame framing plugin).
    - Tabs: 2 top-centre 8 mm bridges and a side tab at each half's outer corner
    (FixedTabs: left / right positions, per-tab width).
    - panel.sh copies the width rules into the panel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
    [hachigo74_panel.kicad_pcb, kugo82_panel.kicad_pcb]
2026-10-19 Angle-keeping grid router; hachigo74 partly routed; fine-pitch J1 rule
    - tools/lib/route_grid.py: A* router on a grid turned to each half's key
    angle (tracks at 15 deg and 45 deg to it; centre at 0 / 45), obstacles
    from the board with its own clearances; pad / component / chain modes,
    reverse search for pads in pockets, per-spot time limit with progress.
    - tools/lib/power_chains.py: 5 V trunk waypoints (one trunk per key row
    and half, thumb keys left out).
    - hachigo74/kicad: matrix, 5 V trunks / branches and LED data on both
    halves, most of the centre fan-out (189 connections open; GND pours,
    J1 / OLED, a few joins and LED_36 still to do).
    - DRC rules: J1 fine-pitch exception (0.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
2026-10-20 Straight bottom edge and re-chained LEDs on hachigo74 and kugo82
    - Bottom edge: the outer columns' keycap bottom line runs straight on until
    it meets the c7_r1 keycap edge (no step under the 2U c5_r1), more room for
    routing; the case-wall screw under c5_r1 follows. Yaml, KiCad boards (via
    kicad_outline_sync.py, routing kept), case STL / STEP / Fusion data and
    the kugo82 panel regenerated.
    - tools/lib/led_rechain.py: re-orders the SK6812 data chain on a routed
    board and renumbers it (LEDk + Ck, nets LED_DATA / LED_k), keeping the
    tracks of unchanged links. Both projects now run MCU -> R1 -> right half
    -> right indicator -> left indicator -> left half; schematics rebuilt
    (ERC 0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
    [center_cover.step, hachigo74.kicad_sch, kugo82.kicad_pcb, kugo82.kicad_sch, kugo82_panel.kicad_pcb, lid_left.step, lid_left.stl, lid_right.step]
2026-10-20 New Helios pin map, GND stitching, hachigo74 routing progress
    - Helios pins moved for cleaner routing (user's map): rows R1-R5 on GP22,
    GP26-29, R6-R10 on GP6/5/4/1/0, columns C1 GP8 (kugo82), C2 GP9, C3-C7
    GP12-16, C8 GP21, C9 GP23, CIRQUE_DR GP7; LED data stays on GP25 (5 V
    shifted). Yamls, both KiCad boards and schematics (ERC 0, parity clean).
    - tools/lib/remap_pins.py: moves nets to other pins of a footprint on a
    routed board, removing only the segments at the changed pins.
    - tools/lib/gnd_stitch.py: GND stitching vias per back-side pour piece;
    hachigo74 got 183 (65 -> 1 open: J1 pin 11 left for hand routing).
    - hachigo74/kicad: the user's routing (signals and 5 V done).
    Co-A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
    [hachigo74.kicad_sch, kugo82.kicad_pcb, kugo82.kicad_sch]
2026-10-21 hachigo74 logo footprint (Keyboard:Logo_hachigo74) and SVG converter
    - tools/lib/svg_logo.py: SVG outline artwork -> silkscreen footprint
    (holes via nesting depth, joined by slits), origin at the top centre.
    - Logo_hachigo74: 41.4 x 14 mm on F.SilkS, board-only, not in BOM / CPL,
    in kicad-libraries and the hachigo74 project library; not placed yet.
    - drafts/hachigo74-logo-check-Artboard-2.svg: the source artwork (outlines).
2026-10-21 LED window corner reliefs, pour refill on panels, 8 mm logo
    - SK6812MINI-E window: r0.5 relief arcs at the corners (JLC mills inner
    corners at R0.5, which left the LED body no room), courtyard y +-1.75 so
    it encloses the cutout. Ergogen footprint, libraries and both project
    boards updated without touching the routing.
    - DRC: copper may come to 0.4 mm of the LED windows (project rules and the
    panel rule in panel.sh, matched by the LED courtyard).
    - Panels refill the zones (refillzones); hachigo74 and kugo82 panels rebuilt.
    - hachigo74 logo footprint at 8 mm with thickened small text (svg_logo.py).
    [hachigo74_panel.kicad_pcb, kugo82.kicad_pcb, kugo82_panel.kicad_pcb]
2026-10-21 kugo82 panel rebuilt with the LED window reliefs and courtyards
    [kugo82_panel.kicad_pcb]
2026-10-21 hachigo74 panel: real outline arcs, refilled pours, fiducials out of the BOM
    - panel.json: reconstructarcs (KiKit had turned the outline arcs into
    ~11,000 short lines, which JLC failed to process).
    - panel.sh: refill and save in the DRC step (KiKit fills before it rebuilds
    the arcs), and exclude KiKit footprints (fiducials, mouse bites, tooling
    holes) from the BOM and position files.
    - hachigo74 board: pours refilled.
    [hachigo74_panel.kicad_pcb]
2026-10-21 hachigo74: JLC order-number text on the back, ordering without our panel
    - JLCJLCJLCJLC on B.SilkS at the board centre (209.9, 96.5), for
    "Order Number (Specify Position)" when JLC adds the rails.
    - ordering/README.md: how to order with JLC-added rails.
2026-10-21 Remove the JLC order-number text: JLC no longer prints order numbers
    Since May 2026 JLC marks nothing by default and asks not to put
    JLCJLCJLCJLC on the silkscreen. ordering/README.md describes the new
    marking options (QR / Data Matrix / serial number).
2026-10-21 Socket outline on the switch footprints; hachigo74 sockets hand-soldered
    - KS-2P02B01-02 body outline (11.85 x 5.39) on the back silkscreen of every
    switch footprint, with a gap at the centre hole: Ergogen footprint,
    libraries, both project boards.
    - hachigo74: hot-swap sockets out of the JLC BOM and position files
    (schematic and board), to be soldered by hand.
    - ordering/README.md: buying the sockets separately (Gateron KS-2P02B01-02).
    [hachigo74.kicad_sch, kugo82.kicad_pcb]
2026-10-22 Manufacturer 3D models, socket outline from Gateron's footprint, longer stab cutouts
    - Vendor models committed in kicad-libraries/3dmodels (vendor_*): Gateron
    socket, KS-33 switch and KS-57 stabilizer, SK6812MINI-E, 0.96" OLED, MBK
    keycaps (STL -> VRML; stl2wrl.js now reads binary STL). Checked against the
    drawings; LED pin-1 lead and chamfer on the GND pad. Project copies are
    gitignored.
    - Switch footprint: stepped socket outline (Gateron footprint's courtyard) on
    the back silkscreen, switch body as corner marks, per-model transforms.
    - KS-57 PCB cutouts y -5.2..+9.8: the lever end reached 0.75 mm past the old
    cutout in Gateron's model.
    - Libraries and both project boards update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
    [kugo82.kicad_pcb, vendor_Gateron_KS-2P02B01-02_socket.step, vendor_Gateron_KS-33_switch.step, vendor_Gateron_KS-57B210T_stabilizer.step, vendor_OLED_128x64.step, vendor_SK6812MINI-E.step]
2026-10-22 hachigo74 order costs; rerouted board (DRC clean)
    - ordering/README.md: the first JLC order (5 PCBs, 4 assembled, DHL DDP),
    EUR 221.84 in total; README: the total in a new Cost section.
    - hachigo74 board: the user's rerouting and fixes; DRC with schematic
    parity 0 / 0 / 0.
2026-10-22 hachigo74 QMK firmware with VIA and KPM, built by GitHub Actions
    - tools/lib/qmk_matrix.py: matrix (switch -> diode -> row), LED chain and key
    names from the routed board -> hachigo74/firmware/matrix.json.
    - tools/lib/qmk_gen.py: keyboard.json (Helios RP2040, 10 x 8 COL2ROW, 76-LED
    RGB matrix, OLED, Cirque I2C), keyboard code (AltGr variants of ( ) @,
    Shift / one-shot Fn and Space / Enter thumb keys, green Fn indicators, OLED
    with layer and 10 s KPM) and the default keymap from the KLE legends; VIA on,
    plus hachigo74_via.json for the VIA app.
    - .github/workflows/firmware.yml: QMK 0.34.7 + our keyboard folder, lint,
    compile, .uf2 as an artifact (no QMK fork).
    - Firmware decisions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
2026-10-22 Firmware: Vial instead of VIA (tapping-term settings on the keyboard)
    - Built with vial-kb/vial-qmk at a pinned commit (dd43959, QMK 0.29 based),
    keymap "vial": Vial + VialRGB, keyboard UID from the name, unlock combo
    left Esc + right Backspace, 4 layers; vial.json is stored in the firmware.
    - The VIA keymap and hachigo74_via.json are gone; custom keys, indicators
    and the OLED / KPM code are unchanged.
2026-10-22 hachigo74 firmware README: flashing and the first test on the board
    Also notes that the Vial build compiles (5ea2d98).
2026-10-23 LED footprint: GND label and pin-1 dot next to the ground marker
    - "GND" (0.8 mm) in line with the marker line beyond its outer end (above /
    below it is the switch's centre hole), and a 0.3 mm pin-1 dot between the
    line and the GND pad at the line's inner end.
    - Ergogen footprint, libraries and all LEDs on both project boards.
    hachigo74 DRC with parity 0 / 0 / 0; kugo82 at its baseline.
    [kugo82.kicad_pcb]
2026-10-23 Remove the KiKit panel tooling; kugo82: matrix and LED data routed in the halves
    - JLC panelizes now (edge rails added by JLC, under the Large Size limit):
    tools/panel.sh, panel_tabs.py, snap_outline.py, both panel.json and the
    *_panel boards removed; notes updated (the venv stays for the routing tools).
    - kugo82, route_grid.py as on hachigo74: switch matrix of both halves (218
    connections) and 78 of 80 LED data links in the halves, no via in a pad.
    Left for manual routing: LED_25, LED_70, the centre, 5 V and GND. Includes
    the user's moved indicator LEDs / caps. DRC with parity: no errors.
    [hachigo74_panel.kicad_pcb, kugo82.kicad_pcb, kugo82_panel.kicad_pcb]
2026-10-23 kugo82: 5 V routed in the halves
    Trunks per key row and half (power_chains.py) plus branches to the LEDs and
    caps, 0.5 mm, no via in a pad. Left for manual routing: the VCC pads of
    LED14, LED23, C23 (right) and LED71 (left), and the 5 V feed in the centre.
    DRC with parity: no errors (track_dangling = trunk ends for the feed).
    [kugo82.kicad_pcb]
2026-10-23 kugo82: user's routing + GND stitching and 5 V trunk fix; leftovers noted
    - The user's routing of the centre and GND pours, plus 218 GND stitching
    vias and the closed right outer-column 5 V trunk gap: unconnected 72 -> 4.
    - kugo82/CLAUDE.md: checklist of the remaining DRC items to fix in KiCad.
    [kugo82.kicad_pcb]
2026-10-24 kugo82: routing finished (DRC clean), logo footprint Keyboard:Logo_kugo82
    - The user's fixes of the leftovers: DRC with pours refilled 0 unconnected,
    0 parity issues, one excluded GND stub near J1.
    - Logo_kugo82 (29.2 x 8.0 mm, "KUGO82 / 82-KEY MATRIX") from the kugo82 logo
    SVG via svg_logo.py (--thicken 0.04), in kicad-libraries and kugo82's
    project library.
    [kugo82.kicad_pcb]
2026-10-24 Clean up drafts; kugo82 board saved
    - drafts/ emptied by the user (the Cirque photos and the first hachigo74 logo
    artwork stay in git history).
    - kugo82 board and project as last saved.
    [kugo82.kicad_pcb]
2026-10-24 Notes: references to removed drafts files reworded
    Vendor originals, MBK keycap STLs and Gateron's footprint folder were the
    user's uploads (not kept); the Cirque photos are in git history before 8a43cce.
2026-10-24 hachigo74: tilt wedge with magnet columns; Fusion bridge
    - tools/lib/wedge_case.py (run by step.sh): separate skeleton wedge under the
    tub, south edge raised (WEDGE_ANGLE, default 6 deg): frame band, rim,
    4 magnet columns per half (3 x 1 magnets), ribs, centre wall with joint
    magnet pairs where the wall is tall enough; STEP/STL + Fusion data.
    - hachigo74.yaml: wedge_socket / wedge_magnet outlines, cut into the tub floor.
    - KeyboardCase.py: build_design() without dialogs, tilt_angle parameter with a
    split plane (small, hidden), side_holes step, degenerate arcs drawn as lines.
    - tools/fusion/Bridge: local Fusion add-in (127.0.0.1 + token) to run test
    code; tools/fusion/fusion_run.py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
    [center_cover.step, lid_left.step, lid_right.step, oled_spacers.step, trackpad_ring.step, tub_left.step, tub_left.stl, tub_right.step]
2026-10-24 keycaps: parametric KS-33 keycap with legend inserts, Orca project
    - keycaps/keycap.py: remake of the user's keycap-10-13.step: 18.2 caps
    (1U, 1.25U, 2U with KS-57 stems), 5 deg skirt, 3 deg sloped top with a
    valley around a flat legend insert pocket (keyed pins), north roll-off,
    thumb versions with a rounded south face; stem 1.3 below the skirt.
    - check_fit.py: travel sweep against the Gateron switch / stabilizer STEP
    models (all clear over 3.0 mm), insert fit, gaps on the layout.
    - assembly.py: key assembly STEP plus cap / insert / legend files.
    - orca_project.py + orca_settings.py: 3MF project (Hungarian alphabet
    inserts, one of each cap lying on the north face) with A1 0.2 nozz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
    [keycap-10-13.step]
2026-10-24 kugo82: 3D views of the routed board (front, back)
2026-10-25 keycaps: Fusion as the cap / insert source, thumb caps, insert 3MFs
    - keycap.py: 0.6 top fillet; thumb caps with square south corners, the
    1.25U thumb curve scaled down through the skirt edge (no south skirt left);
    corner radii shrink with the draft (tapered-extrude rule); recipe export
    (--fusion) for the Fusion builder; get_cap() / get_insert() load the
    Fusion exports; the legend list comes from keycaps/inserts.txt.
    - keycaps/fusion/KeycapBuilder: Fusion script rebuilding each cap as a
    parametric design (timeline group per stage, user parameters draft /
    slope / top_fillet) and the legend inserts (legend in its own
    sub-component, text height = build123d capital height); saves .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
2026-10-26 keycaps: Bambu Studio 3MF exports instead of OrcaSlicer
    - orca_project.py / orca_settings.py -> bambu_project.py / bambu_settings.py;
    print settings from Bambu Studio's installed presets (includes merged, e.g.
    the A1 start / end G-code; keys Bambu never writes into projects left out),
    its version in the 3MF headers, importable presets in keycaps/bambu/.
    - Bambu Studio's GUI accepts the files now (checked by the user): names
    without <>:/\|?*" (safe_name), the per-filament fields of Bambu Studio 2.x
    (filament_ids, filament_self_index, filament_map, ...) one entry per
    filament, no preset-only fields; prime tower placed on the bed.
    - Slices with "Success" in Bambu Studio's CLI (both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
2026-10-27 keycaps: printed-in legend caps (double-shot split), blank version
    legend_cap.py: a second keycap approach next to the insert caps. No pocket,
    the top is one smooth surface (sloped plane - dish - north roll-off, no ridge
    where the dish met the roll-off), and the cap is split like a double-shot
    moulding: a translucent core (stems, a 0.5 layer over the cavity ceiling, the
    legend reaching up through the top) under an opaque shell. The legend sits
    north-west of the top's centre point. Stem 5.0 on these caps. A blank
    version (--legend '') is the same shape in one material.
    keycap.py: valley_style 'dish', top_points() / top_tool(), pocket / cavity /
    ceiling switches, wall_inside().
    KeycapBuilder: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
2026-11-03 hachigo74: tub joint reinforcement (dovetails, bridge plate)
    Dovetails: 3 floor tails and 1 south wall tail on tub_right, sockets in
    tub_left, 0.15 clearance per side. No north wall tail (USB opening).
    New part center_bridge: 138 wide, 1.5 thick plate on the tub floor across
    the joint, close holes round the centre posts, glue optional.
    Checked against the routed board's 3D model and built in Fusion.
    [center_bridge.step, center_bridge.stl, center_cover.step, lid_left.step, lid_right.step, oled_spacers.step, trackpad_ring.step, tub_left.step]
2026-11-04 hachigo74: PCB gap, OLED fit, dovetail clearance; switch hole 5.15
    - Tub: 0.25 clearance round the PCB (tub_cavity), lower posts clipped to it.
    - Dovetail sockets 0.10 larger per side (0.15 printed too loose; 0.10 fits
    on the printed test strip, case/test/).
    - Cover: pocket ceiling z 14.5 from the measured OLED, bosses with a flat
    on the glass side.
    - Switch footprint centre hole 5.15 (the routed KiCad project is unchanged).
    - Notes: the Helios bootloader needs a long reset press, not a double tap.
    [center_bridge.step, center_cover.step, center_cover.stl, dovetail_strip.f3d, dovetail_strip_left.step, dovetail_strip_left.stl, dovetail_strip_right.step, dovetail_strip_right.stl]
2026-11-04 hachigo74: plate ribs in the lids
    The ribs were only a Fusion option, so no STL or STEP had them. They are now
    outline plate_ribs in the lid recipes (z 10.4-11.4), and the Fusion script no
    longer asks for this design. The 2U relief goes round the stabilizer housings
    as they are in Gateron's STEP; the old option's relief hit both.
    [center_bridge.step, center_cover.step, lid_left.step, lid_left.stl, lid_right.step, lid_right.stl, oled_spacers.step, trackpad_ring.step]
2026-11-04 hachigo74: case fit changes, Fusion top fillets, KiCad holes 5.15
    Case:
    - switch cutouts 14.06 (14.1 printed too big; test strip in case/test)
    - USB opening z 3-9.9: 3 mm floor, 1.5 mm tub strip above it
    - half crosses beside the Helios, trackpad support ring
    - OLED plate opening 0.5 further north, square corners
    - 4 centre posts: 3 mm inner hole
    Fusion script: 1 mm top outside fillet on the lids, 1.5 mm on the wedges
    (Fusion only; the STL and STEP files stay square).
    KiCad project: switch centre holes 5.15, new front support marks, zones
    refilled; tracks and vias unchanged, DRC clean.
    Notes: the OLED module's holes are 23.6 apart, the board's 22.352.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
    [center_bridge.step, center_cover.step, lid_left.step, lid_left.stl, lid_right.step, lid_right.stl, oled_spacers.step, switch_cutout_14.06_strip.step]
2026-11-05 hachigo74: lid chamfer 0.5 instead of the fillet, full case as .f3d
    [hachigo74_case.f3d]
2026-11-05 hachigo74: screw-on trackpad ring, OLED holes 23.6 apart, open USB wall
    - Trackpad: the pad is the 46.13 mm curved ABS overlay (datasheet p. 13), not
    the 40 mm board. It now sits in a 1 mm recess in the centre cover on its
    bottom flange, held by a ring screwed onto a collar of the cover (M50x1.5,
    modeled in Fusion with a thread_play offset); a sleeve under the ring's lip
    presses the 1.7 mm flange. Anti-rotation pin in the overlay's notch. Snap
    ring claws, their plate slots and the old peg removed; cover circle r 29.3.
    - Threaded cover and ring exported from Fusion (case/fusion/*_threaded.stl);
    print settings for the threads noted in hachigo74/CLAUDE.md.
    - South cover screws go to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
    [center_bridge.step, center_bridge.stl, center_cover.step, center_cover.stl, center_cover_threaded.stl, hachigo74_case.f3d, kugo82.kicad_pcb, lid_left.step]
2026-11-05 hachigo74: KiCad trackpad silkscreen 46.13 mm, OLED mounting plans
    - KiCad project: the trackpad's front silkscreen mark is the 46.13 mm
    overlay circle (was the 40 mm board's two arcs), as Ergogen draws it;
    DRC unchanged (0 violations, 0 unconnected, 0 parity).
    - Notes: OLED on the first boards (drill out, or pin spacers keyed into
    the module's holes) and the plan for future builds (OLED further north,
    no screw holes in the main PCB, header + spacers, cover holds it down).
2026-11-06 hachigo74: trackpad ring seat, 2.5 mm thread, solid ring top with a 4 x 1 fillet
    - Cover: seat under the ring (r 26.5, z 15.5-16.2) level with the overlay
    flange top; collar z 15.5-18.7, thread 16.2-18.7 (2.5 engaged).
    - Ring: bottom and sleeve both end at z 16.2 (flat, prints top up);
    internal thread z 16.2-18.9, solid top 18.9-20.3.
    - KeyboardCase: asymmetric top fillet on the ring (ring_fillet_h 4,
    ring_fillet_v 1); top_outer_edges handles a single-circle outline.
    - Regenerated case STLs / STEP, Fusion data, .f3d and threaded STLs.
    [center_bridge.step, center_cover.step, center_cover.stl, center_cover_threaded.stl, hachigo74_case.f3d, lid_left.step, lid_right.step, oled_spacers.step]
2026-11-07 hachigo74 firmware: trackpad rotated 90 deg
    The Cirque's axes were turned (finger up -> cursor right, right -> down);
    POINTING_DEVICE_ROTATION_90 maps x, y -> y, -x. Also a note to check
    later: a PCB cutout to extend 1 mm to the south.
2026-11-07 hachigo74: the user's OLED spacers (spacers.f3d)
    Pin spacer (Ø5 x 1.1 + Ø2 x 0.8 pin) and a plain Ø5 / Ø3 x 1.1 ring,
    made to the physical OLED module; noted in hachigo74/CLAUDE.md.
    [spacers.f3d]
2026-11-07 hachigo74: OLED window 23 x 15 moved south, 1.1 spacers, Bri+/- keys
    - Cover screen window: 15 high, north edge 1.2 further south (the LCD is
    15 high and the old window sat north of it).
    - oled_spacers 1.1 tall (like the user's spacers.f3d).
    - Firmware: the old Vol+ / Vol- keys are RGB brightness up / down
    (RM_VALU / RM_VALD), 10 % steps of the 40 cap, 20 % at every start.
    - Case STLs / STEP and Fusion data rebuilt; the .f3d and the threaded
    STLs are not (later, with the next case changes).
    [center_bridge.step, center_cover.step, center_cover.stl, lid_left.step, lid_right.step, oled_spacers.step, oled_spacers.stl, trackpad_ring.step]
2026-11-07 hachigo74: QK_BOOT on Fn + Esc, case .f3d and threaded STLs rebuilt
    - Firmware: Fn + Esc restarts into the RP2040 bootloader for flashing.
    - Fusion rebuild with the 23 x 15 OLED window and the 1.1 spacers:
    269 timeline items healthy, threaded cover / ring STLs closed.
    [center_cover_threaded.stl, hachigo74_case.f3d, trackpad_ring_threaded.stl]
2026-11-07 hachigo74: OLED bosses removed from the cover, two-distance top chamfers
    - centre cover: the OLED screw bosses on its underside removed (not needed)
    - Fusion KeyboardCase: TOP_EDGES kind 'chamfer2' (two-distance chamfer round the
    outer loop of the largest top face, direction checked by probe points);
    trackpad ring 3 x 1 (was a 4 x 1 asymmetric fillet), centre cover top
    outline 2.5 x 1
    - case STLs / STEPs / json, .f3d and threaded STLs rebuilt
    [center_bridge.step, center_cover.step, center_cover.stl, center_cover_threaded.stl, hachigo74_case.f3d, lid_left.step, lid_right.step, oled_spacers.step]
2026-11-07 hachigo74: OLED window 23 x 14 with a chamfer, T clip at the cover's north edge
    - centre cover: OLED window 23 x 14 (north edge kept), its top edge chamfered
    1 x 0.5 in Fusion (TOP_HOLES, window_chamfer_h / _v)
    - new part cover_clip: a T glued into a socket in the cover's underside, its
    stem through half notches in the lid plates at the joint, its bar under
    both plates (between the Helios pin rows); the lids slide in sideways under
    it. Lead-in chamfers on the bar's east / west top edges (Fusion,
    END_CHAMFERS, clip_chamfer_h / _v 1.5 x 0.5); print cover_clip_chamfered.stl
    - case.sh / step.sh build cover_clip
    - case STLs / STEPs / json, .f3d and Fusion STLs rebuilt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
    [center_bridge.step, center_cover.step, center_cover.stl, center_cover_threaded.stl, cover_clip.step, cover_clip.stl, cover_clip_chamfered.stl, hachigo74_case.f3d]
2026-11-07 hachigo74 firmware: the user's Vial layout as the default keymap, Vial layer names, indicator LEDs
    - default keymap from firmware/vial_default.vil (the user's Vial layout, all 4
    layers); qmk_gen.py renames Vial's old names to the same codes (KC_BSPACE ->
    KC_BSPC, RGB_MOD -> UG_NEXT, USER00..02 -> the custom keys) and checks them
    - layers named as in Vial: BASE / FN1 / FN2 / FN3 on the OLED (was HIGH / LOW / L3)
    - OLED: the FN text on line 2 removed, CAPS moved up to line 2
    - left indicator LED = layer (Fn1 green, Fn2 blue), right = Shift held or
    Caps Lock (yellow)
    - OLED and key LED idle timeout 15 min
2026-11-07 hachigo74: OLED window 24 x 14 (0.5 wider each side)
    - centre cover: the screen window 0.5 wider east and west (24 x 14, still
    centred; north / south edges unchanged), Fusion's window chamfer follows
    - case STLs / STEPs / json, .f3d and Fusion STLs rebuilt
    [center_bridge.step, center_cover.step, center_cover.stl, center_cover_threaded.stl, cover_clip.step, hachigo74_case.f3d, lid_left.step, lid_right.step]
2026-11-07 hachigo74 firmware: readme screen / LED guide, Vial tap dances as defaults
    - readme.md: OLED screen table (what each line shows) and the indicator LEDs
    - keymap from the updated firmware/vial_default.vil, its tap dances carried
    over: Vial has no compile-time tap dance defaults, so keymap.c writes them
    once after each EEPROM reset (keyboard_post_init_user, a bit in the user
    EEPROM word as the marker): TD(0) Shift / Caps on double tap, TD(1) / TD(2)
    MO / TG of layers 1 / 2
2026-11-07 hachigo74 firmware: modifiers on the right indicator LED and the OLED
    - right indicator LED: yellow Shift, purple Ctrl, white Alt (AltGr too) while
    held (Shift > Ctrl > Alt), else yellow for Caps Lock
    - OLED line 2: the held modifiers joined by + (SHFT+CTRL, ...; +ALT on line 3
    with all three), else CAPS; T and + added to the font
    - readme and notes updated
2026-11-07 ordering: cost of one hachigo74 (all parts), European FFC source
    - ordering/README.md: table of every part of one keyboard (PCB share, Helios,
    OLED, Gateron switches / sockets / stabilizers, Cirque trackpad, FFC,
    screws), about EUR 137 without shop shipping, filament and keycaps; prices
    the user paid where known, else list prices of 2026-11-07
    - FFC from a European distributor (GCT 05-12-D-0030-A-4-06-4-T, opposite-side
    contacts), to add to the Mouser trackpad order instead of LCSC's shipping
    - README.md: cost summary points to it
2026-11-07 ordering: screws EUR 10 (mixed-length pack), filament estimate, magnets unknown
2026-11-07 notes: OLED without screws for hachigo74 v2 and kugo82 v1
    The OLED rests on the pin spacers and its header, the centre cover holds it
    down: drop the OLED screw holes from the PCB and put half crosses instead of
    the OLED screw posts in the tubs (decision recorded, not yet applied).
2026-11-07 hachigo74 v2 / kugo82 v1: OLED without screws, pin spacers, lid hole fix, kugo82 gets hachigo74's centre
    hachigo74:
    - no OLED screws: the PCB holes, tub posts, floor counterbores and insert
    holes are gone; half crosses (T) under the PCB where the posts were, the
    bridge plate 0.2 clear of them
    - oled_spacers = the user's pin spacer (spacers.f3d Body1): Ø5 x 1.1 with a
    Ø2 x 0.8 pin at the module's north holes, now in the main case model
    - lid: the screw holes are cut through the rib layer too (the ribs closed the
    c5/c6 one on both halves)
    - KiCad project: the 2 OLED holes and their rings removed, pin spacer and
    half cross marks added, zones refilled; tracks unchanged, DRC clean
    ku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
    [center_bridge.step, center_bridge.stl, center_cover.step, center_cover.stl, center_cover_threaded.stl, cover_clip.step, cover_clip.stl, cover_clip_chamfered.stl]
2026-11-08 ordering: filament 180 g for the case, the wedge 90 g on its own
2026-11-08 README: kugo82 KiCad render; public copy: noreply commit email
2026-11-09 keycaps: monolithic caps only, tall 2U and slope test caps, build/ + results/ layout
    - Dropped the insert caps (pocket + printed legend insert): their code, inserts,
    assembly and Bambu project. The caps are now blank (for solvent-transfer legends)
    or two-colour (double-shot shell / core), every size from legend_cap.py:
    1U, 1.25U, 1.25U thumb, 2U, 2U thumb and a tall 2U (two switches of a column,
    a stem on each, level ceiling).
    - Slope test caps (+3 / 0 / -3 deg) to decide the lean per row.
    - No STL files: STEP + 3MF only; shell and core always in one file (Fusion
    exports one 3MF per cap, the print 3MF reads its meshes from it).
    - Fusion builder: insert steps removed, stems with y,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
    [cap_1.25u_A.3mf, cap_1.25u_blank.3mf, cap_1.25u_thumb_A.3mf, cap_1.25u_thumb_blank.3mf, cap_1u_A.3mf, cap_1u_blank.3mf, cap_1u_slope_+3.3mf, cap_1u_slope_-3.3mf]
2026-11-10 keycaps: off-centre and level thumb-cluster caps, south face up, Generic PLA
    - '@x' specs put the switch stem off the cap centre: 1.5U at c7_r1 (+-0.5),
    1.25U at c9_r1 (+-1.5, normal shape; thumb versions kept as backups); 1.35U
    - 'l' specs: level top (slope 0) for the thumb cluster (2U stab, 1.25U,
    1.35U, 1.5U / 1.25U off-centre)
    - 3MFs: south skirt face on top and horizontal (thumb caps still lie on the
    north face); Generic PLA on both filaments (PolyTerra preset dropped);
    supports on project-wide too (imported caps keep them)
    - mesh(): weld build123d's per-face tessellation (open edges in Bambu Studio)
    [cap_1.25u_A.3mf, cap_1.25u_blank.3mf, cap_1.25u_level_A.3mf, cap_1.25u_level_blank.3mf, cap_1.25u_level_stem+1.5_A.3mf, cap_1.25u_level_stem+1.5_blank.3mf, cap_1.25u_level_stem-1.5_A.3mf, cap_1.25u_level_stem-1.5_blank.3mf]
2026-11-10 keycaps/results: blank/ and multicolor-legend/ subfolders
    The print 3MFs (and the local Fusion .f3d) go to results/blank or
    results/multicolor-legend by legend (keycap.results_dir()); legend_cap.py,
    slope_test.py and the Fusion KeycapBuilder write there.
    [cap_1.25u_A.3mf, cap_1.25u_blank.3mf, cap_1.25u_level_A.3mf, cap_1.25u_level_blank.3mf, cap_1.25u_level_stem+1.5_A.3mf, cap_1.25u_level_stem+1.5_blank.3mf, cap_1.25u_level_stem-1.5_A.3mf, cap_1.25u_level_stem-1.5_blank.3mf]
2026-11-10 Restore the current KiCad board and 1:1 printout
    Their earlier versions are left out of this public history (they contained logo
    artwork); these are the clean current versions. Datasheet PDFs are not included:
    datasheets/LINKS.md lists where to get them.
    [hachigo74.kicad_pcb]
